amsikking/idv-snouty_light-sheet_microscopy/README.md

# Instant dual-view Snouty (iDV-Snouty) light-sheet microscopy



A scientific publication that describes a new approach to dual-view light-sheet microscopy. This repository 
hosts all the publication materials. Read the publication here:

https://amsikking.github.io/idv-snouty_light-sheet_microscopy

This repository is intended to hold a (mostly) self-contained publication. It contains:

* HTML (`index.html` and `appendix.html`), `javascript` and CSS (`stylesheets`) directories, `images` and `figures` directories and `cad`, `parts` and `zemax` directories.
* A (limited) PDF version of the publication; note that this does not include animated/interactive figures.

This work is licensed under a <a rel="license" href="http://creativecommons.org/licenses/by/4.0/">Creative Commons Attribution 4.0 International License</a>.



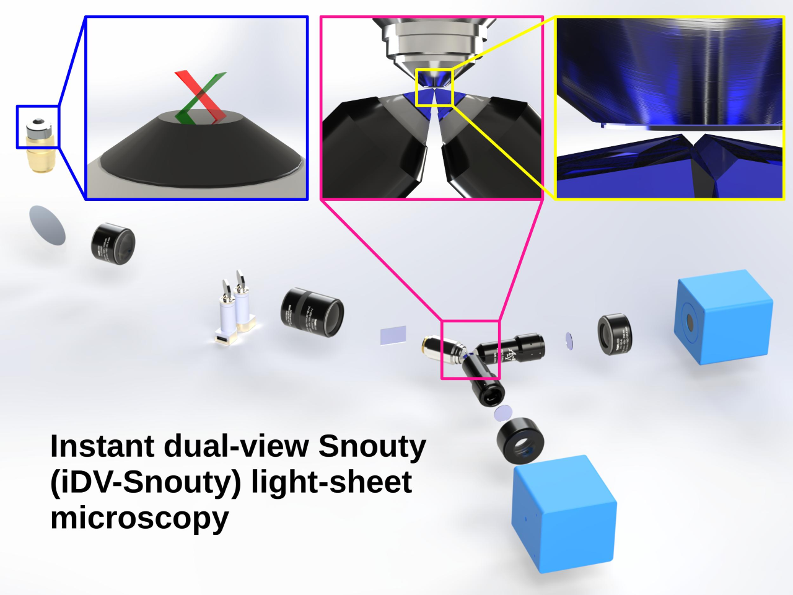
[picture p1: social_preview.png]
social_preivew
