amsikking/idv-snouty_light-sheet_microscopy/cad/improved_design/index.html

# Index of /CAD/improved_design

- 📁 Parent Directory
- 📁 m3_improved_design/
- 📁 rr_dl_volume_improved_design/
- 📄 idv_snouty_improved_design.EASM
- 📄 idv_snouty_improved_design.SLDASM
- 📄 idv_snouty_improved_design.SLDDRW
- 📄 idv_snouty_improved_design.STEP
- 📄 idv_snouty_improved_design.pdf
- 📄 idv_snouty_improved_design_render_overview.png
- 📄 idv_snouty_improved_design_render_rr_zoom1.png
- 📄 idv_snouty_improved_design_render_rr_zoom2.png
- 📄 idv_snouty_improved_design_render_rr_zoom3.png

GitHub Pages Directory Explorer
