amsikking/idv-snouty_light-sheet_microscopy/figures/visual_abstract.odp

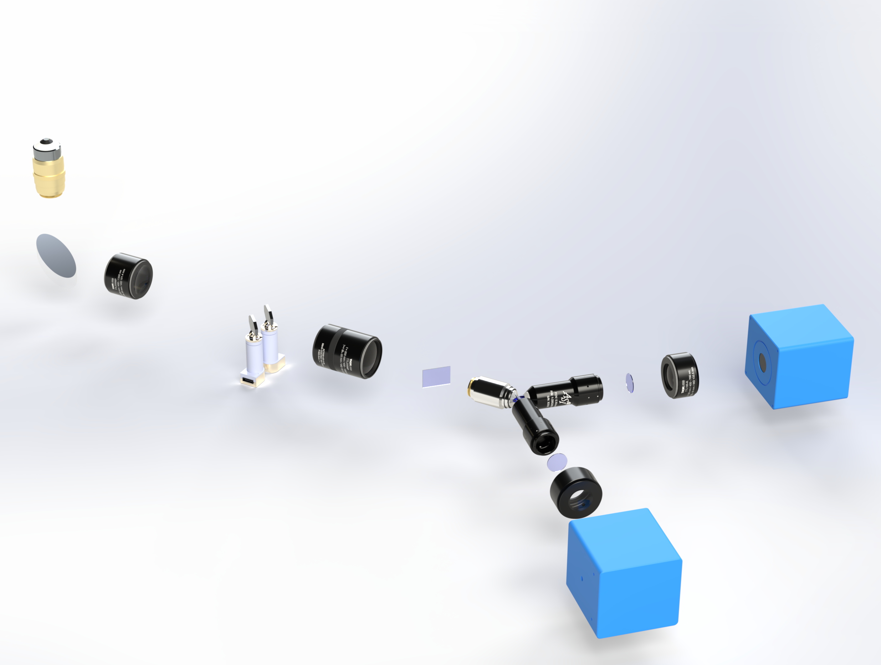
[picture p11: figure]

Instant dual-view Snouty (iDV-Snouty) light-sheet microscopy

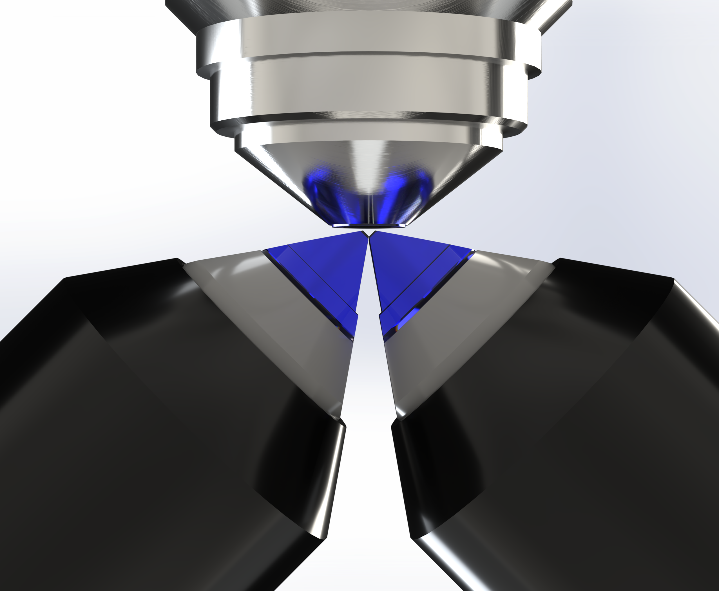
[picture p12: figure]
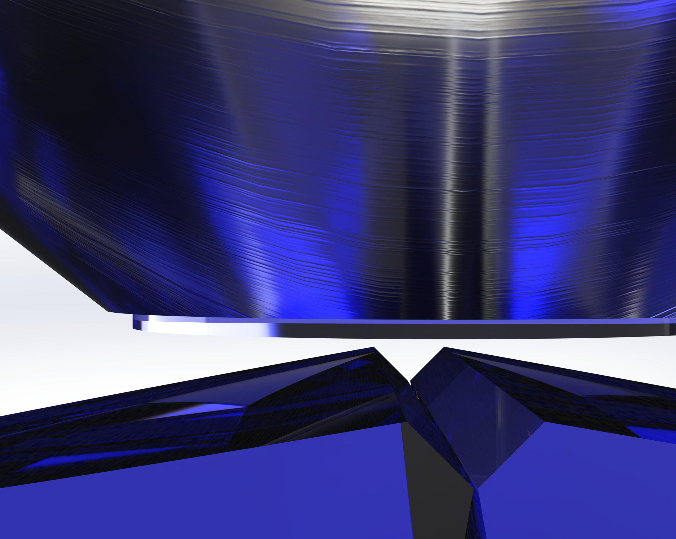
[picture p13: figure]
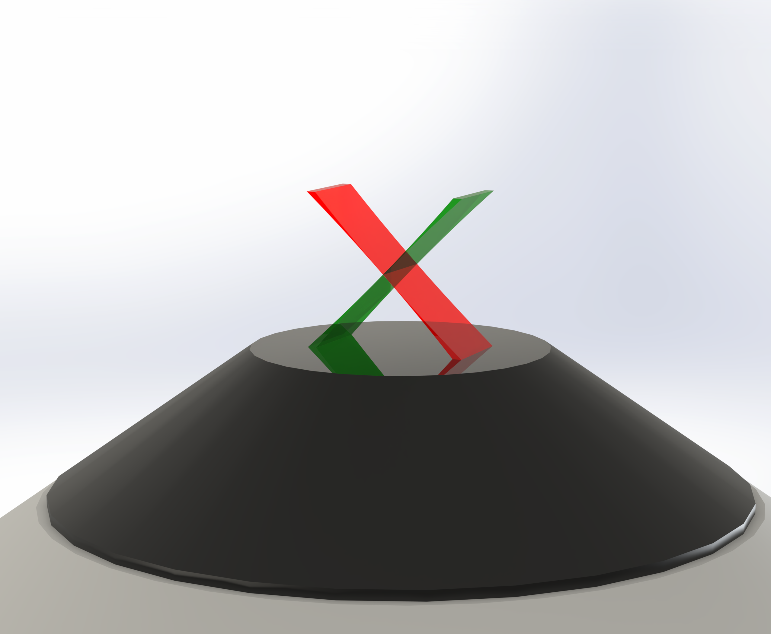
[picture p14: figure]
