amsikking/idv-snouty_light-sheet_microscopy/figures/master.odp

Instant dual-view Snouty: master

FOV1

NA1

NAs

shift

LS1

LS2

tilt

M4

V2

O1

AF*

OS*

DM

O2

FOV2

NA2

CS

Remote

3D image

MRR

shift

FM*

M2

TL2

FOV3

NA3

O3

EM

PG*

tilt

TL1

M1

TL3

C

M3

V1

## Slide 2

Instant dual-view Snouty

LS2

LS1

tilt

M4

V2

Remote

3D image

M2

tilt

M1

M3

V1

## Slide 3

Single-view Snouty: tilt

LS1

tilt

O1

O2

MRR

tilt

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
## Slide 4

FOV1

NA1

Single-view Snouty: NA and FOV

NAs

O1

O2

FOV2

NA2

MRR

M2

TL2

FOV3

NA3

O3

TL1

TL3

M1

M3

V1

## Slide 5

shift

Single-view Snouty: lateral shift

O1

FOV1

OS*

O2

FOV2

MRR

shift

M2

TL2

FOV3

O3

TL1

M1

TL3

M3

V1

## Slide 6

!

Instant dual-view Snouty: axial sample position

deep

regime

LS2

LS1

LS2

LS1

V2

V2

O1

shallow

regime

O1

O2

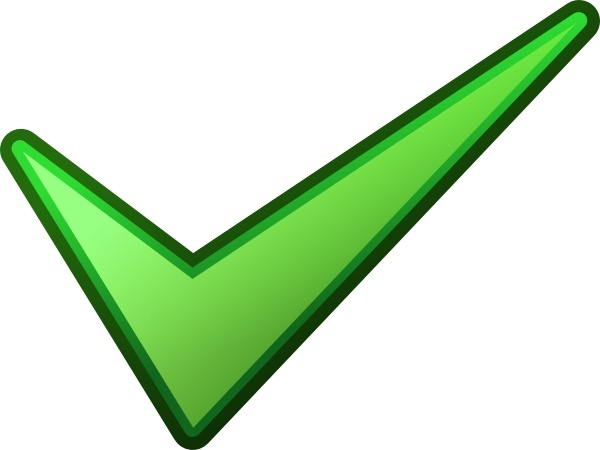
[picture p15: figure]

O2

cross-talk

O3

(V1)

(V2)

O3

(V1)

(V2)

V1

V1

## Slide 7

Instant dual-view Snouty: all labels

FOV1

NA1

NAs

shift

LS1

LS2

tilt

M4

V2

O1

AF*

OS*

DM

O2

FOV2

NA2

CS

MRR

shift

FM*

M2

TL2

FOV3

NA3

O3

EM

PG*

tilt

TL1

M1

TL3

C

M3

V1

## Slide 8

Instant dual-view Snouty: remote space render

current design

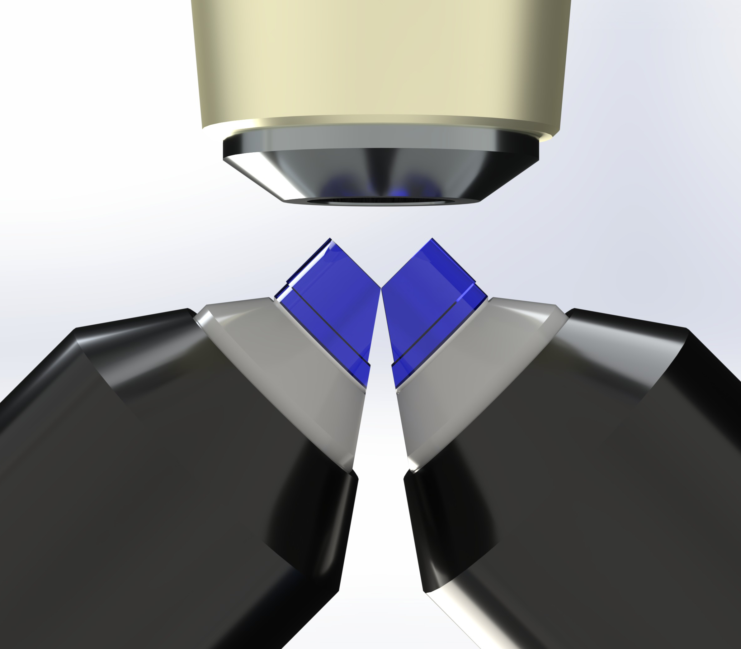
[picture p16: figure]

Nikon 20x0.45 air +

2 × ‘250µm grind’

AMS-AGY v3 objective

improved design

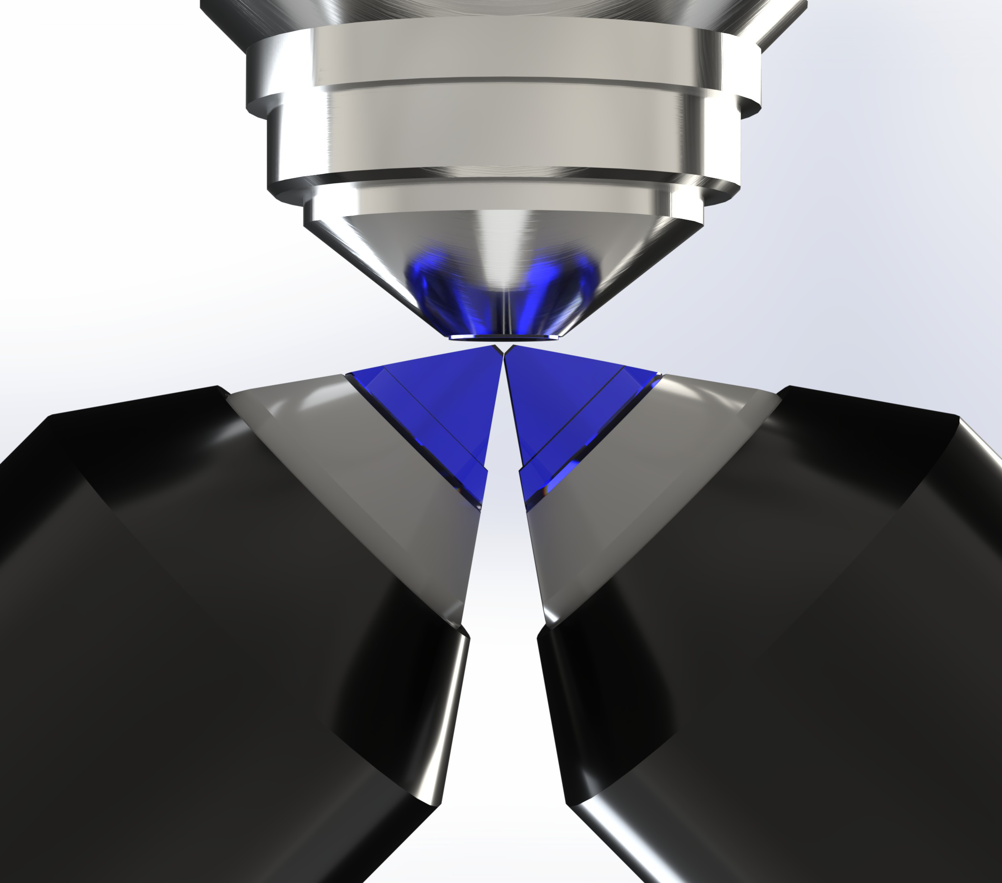
[picture p17: figure]

Nikon 20x0.80 air +

2 × ‘dual-grind’

AMS-AGY v3 objective

O2

O2

O3

O4

O3

O4

## Slide 9

Instant dual-view Snouty: ‘dual-grind’ AMS-AGY v3

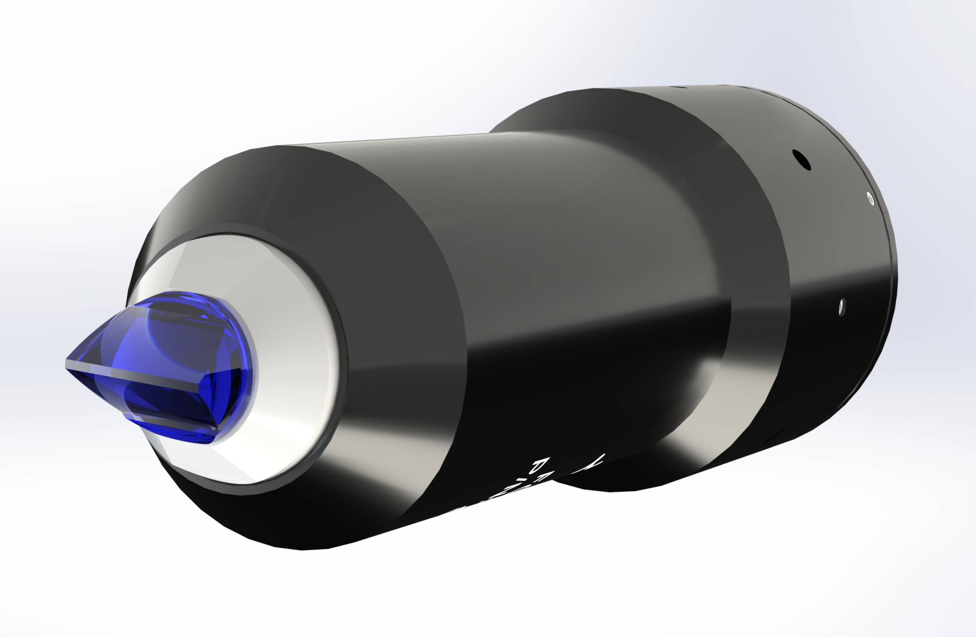
[picture p18: figure]

## Slide 10

FOV3 = 600um

FOV3 = 600um

Snouty light-sheet microscope: 2D field of view (FOV)

FOV2 >= 1100 µm

## Slide 11

Snouty light-sheet microscope: field of view (FOV)

FOV2 = ns FOV1

FOV3 = (NA1 / ns) FOV2

(NA1 / ns = 0.75 here)
