amsikking/idv-snouty_light-sheet_microscopy/cad/current_design/idv_snouty_current_design_render_overview.png

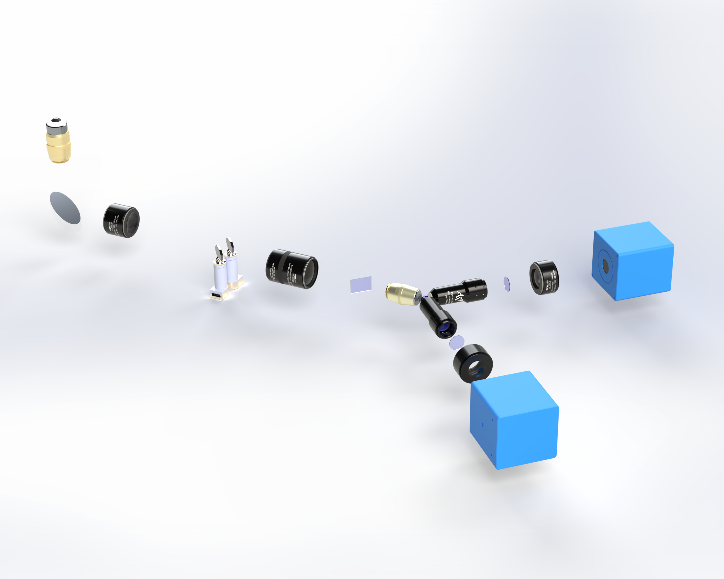
cad/current_design/idv_snouty_current_design_render_overview.png
