amsikking/idv-snouty_light-sheet_microscopy/cad/current_design/idv_snouty_current_design_render_rr_zoom.png

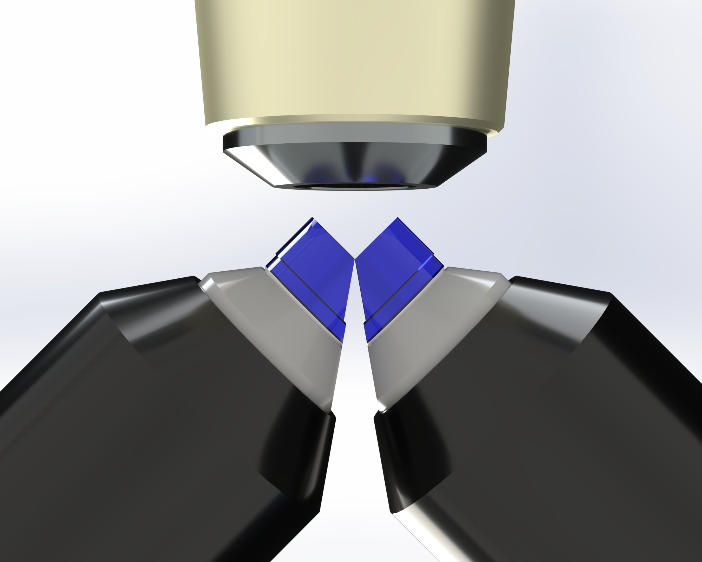
cad/current_design/idv_snouty_current_design_render_rr_zoom.png
