amsikking/idv-snouty_light-sheet_microscopy/cad/improved_design/idv_snouty_improved_design_render_overview.png

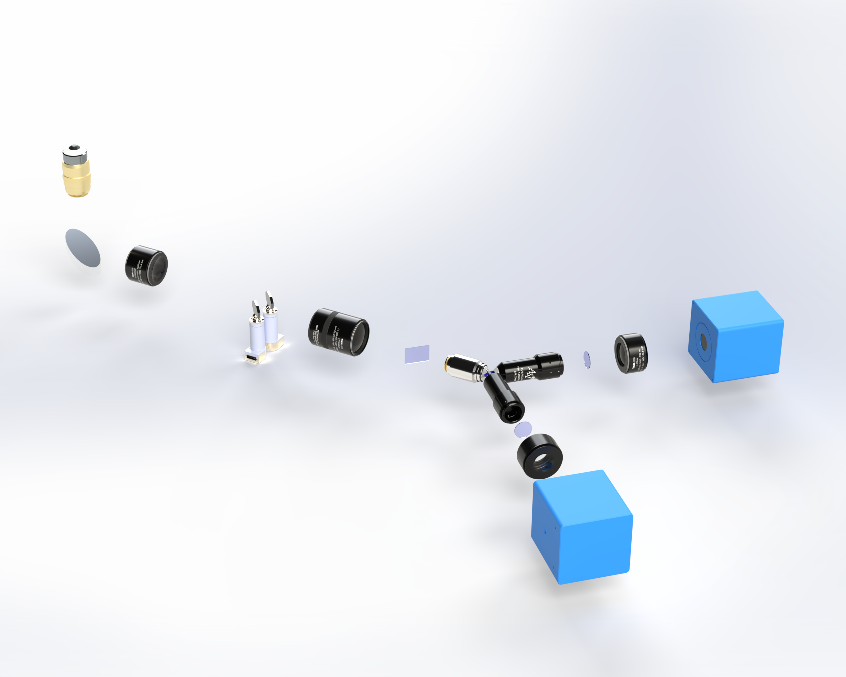
cad/improved_design/idv_snouty_improved_design_render_overview.png
