amsikking/idv-snouty_light-sheet_microscopy/cad/improved_design/idv_snouty_improved_design_render_rr_zoom1.png

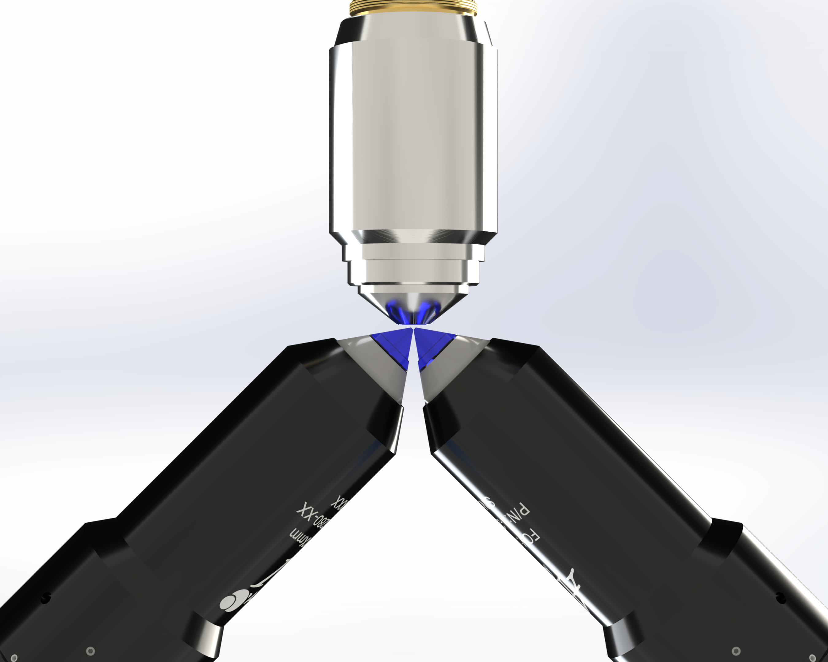
cad/improved_design/idv_snouty_improved_design_render_rr_zoom1.png
