amsikking/idv-snouty_light-sheet_microscopy/cad/o1/o1_lightsheets_render_zoom1.png

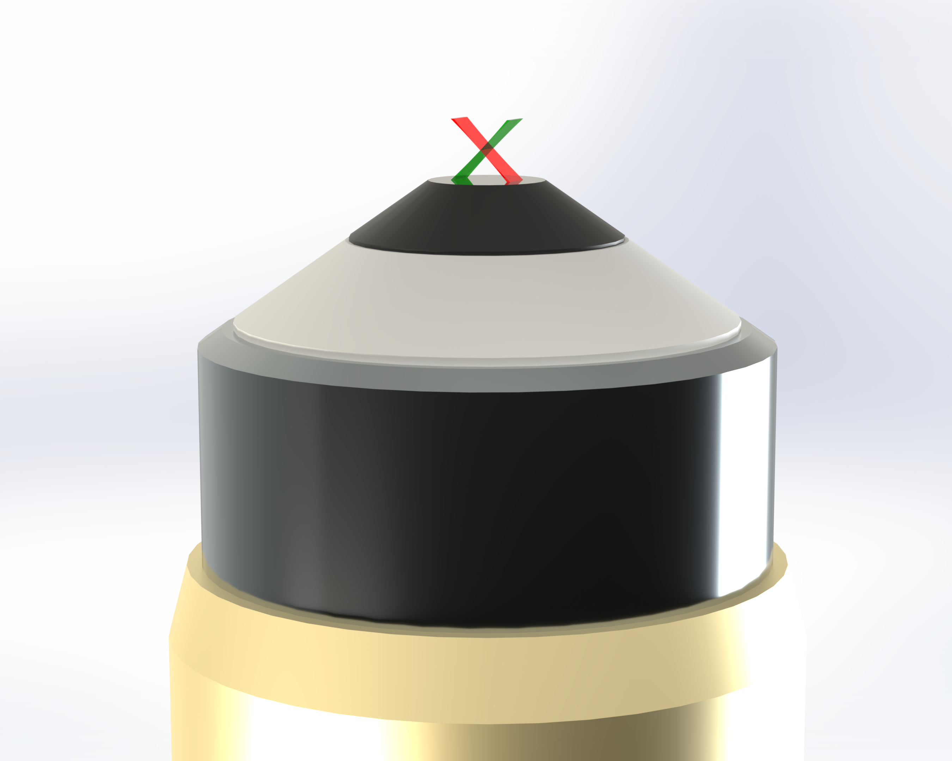
cad/o1/o1_lightsheets_render_zoom1.png
