amsikking/idv-snouty_light-sheet_microscopy/cad/o3/ams-agy_v3_57-14-7_revb_dual_grind_render.png

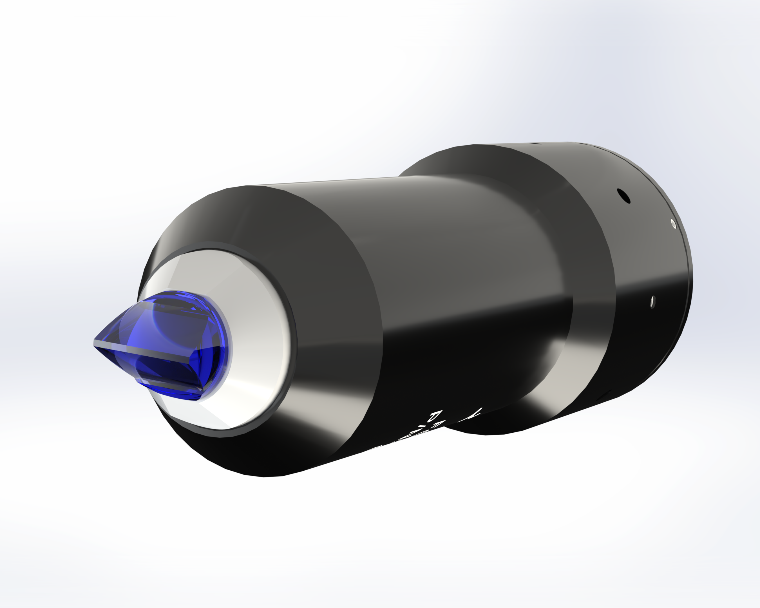
cad/o3/ams-agy_v3_57-14-7_revb_dual_grind_render.png
