amsikking/idv-snouty_light-sheet_microscopy/figures/ams-agy_v3_dual_grind_render.png

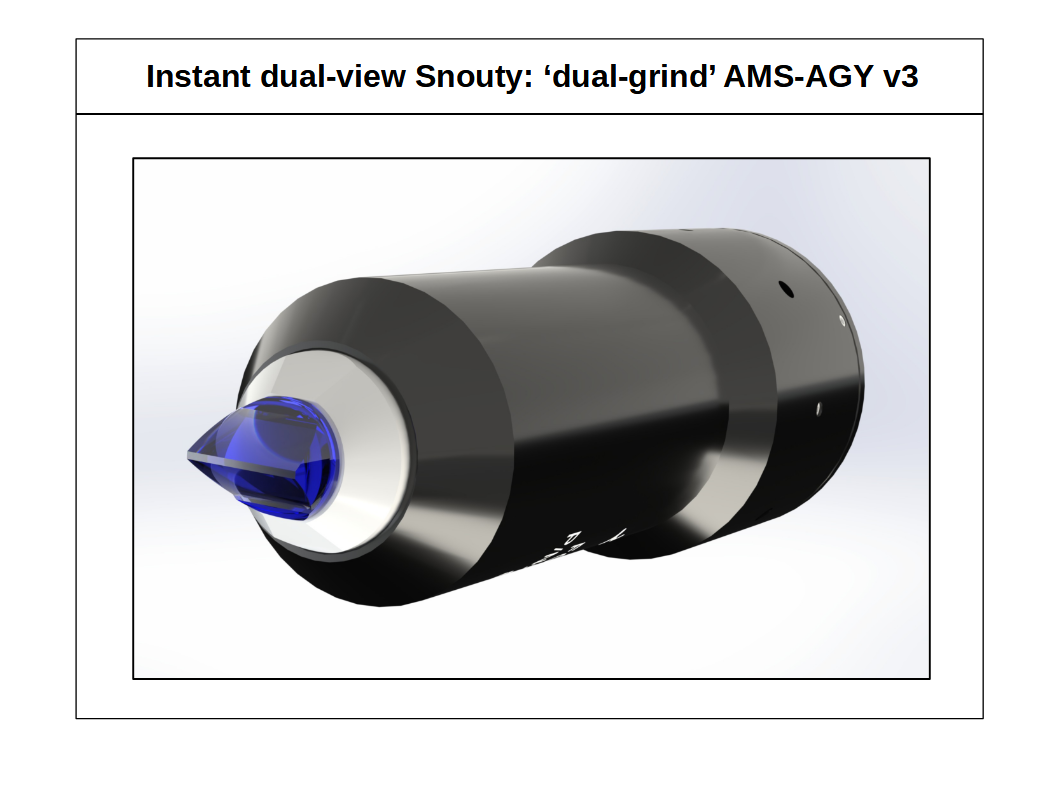
figures/ams-agy_v3_dual_grind_render.png
