amsikking/idv-snouty_light-sheet_microscopy/figures/idv_snouty.png

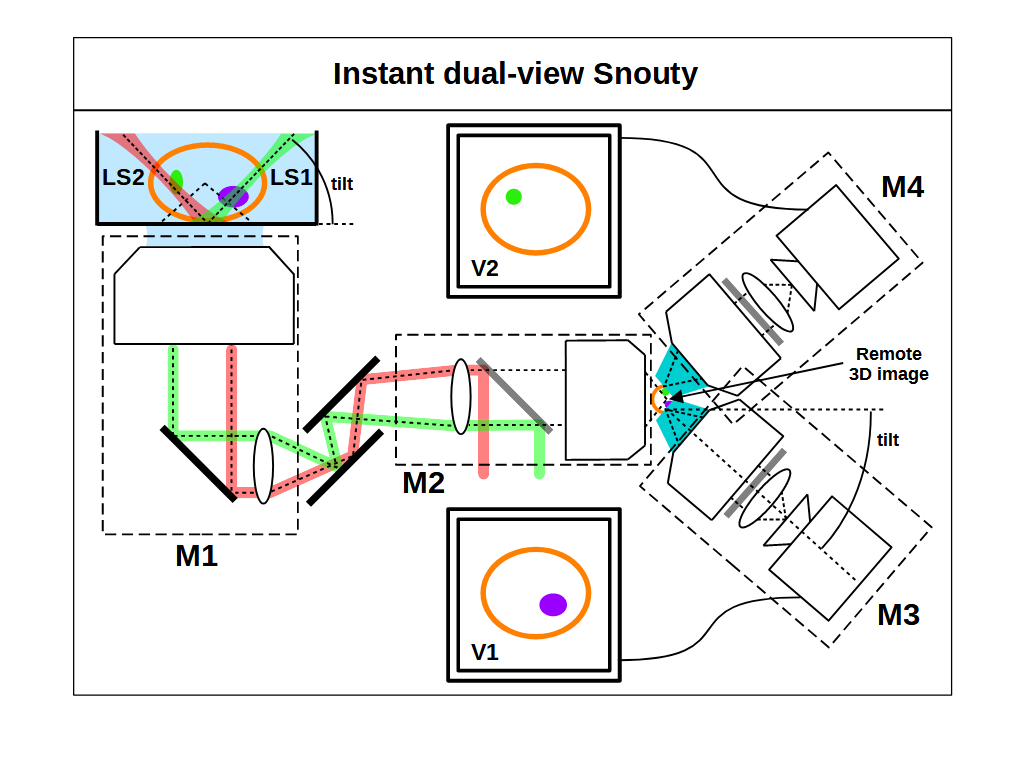
figures/idv_snouty.png
