amsikking/idv-snouty_light-sheet_microscopy/figures/idv_snouty_axial_sample_position.png

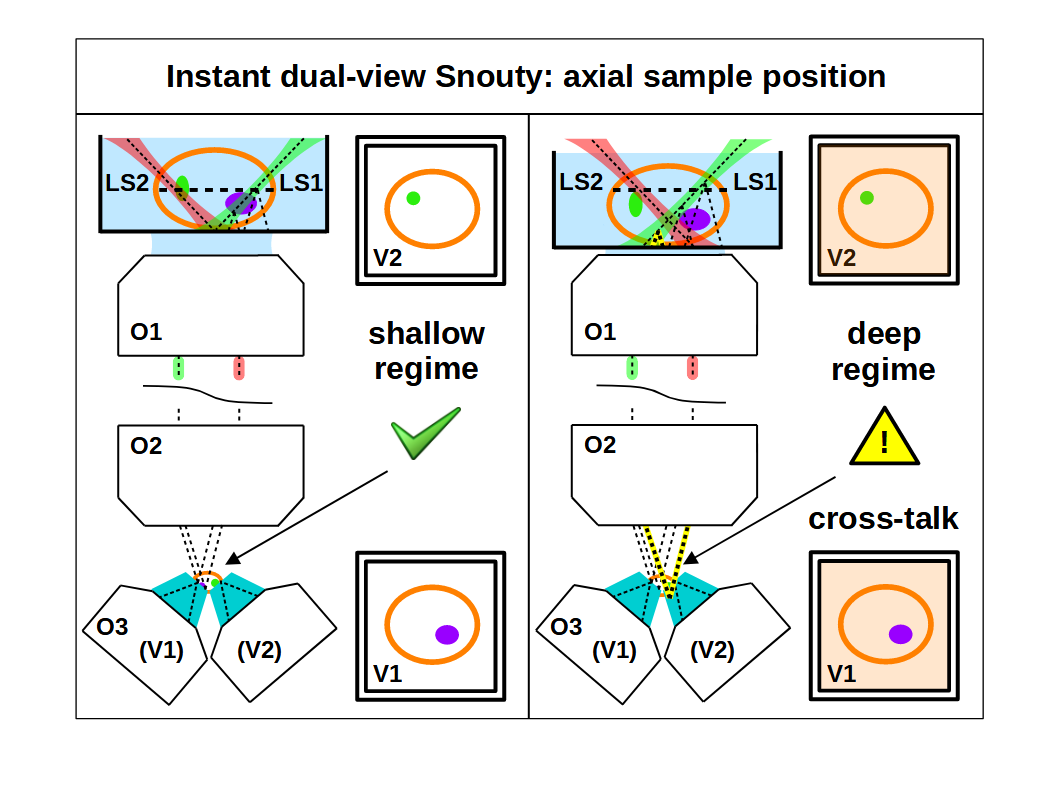
figures/idv_snouty_axial_sample_position.png
