amsikking/idv-snouty_light-sheet_microscopy/figures/idv_snouty_improved_design_3d_fov_detail.png

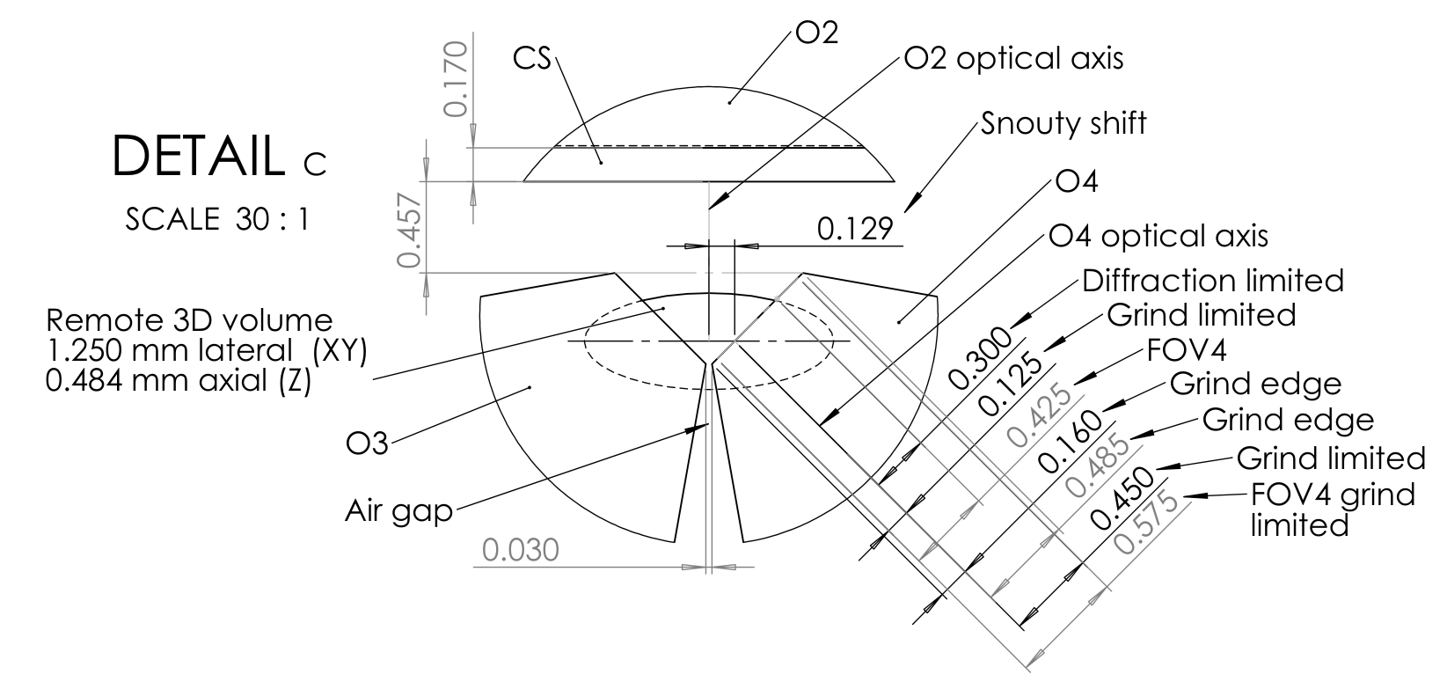
figures/idv_snouty_improved_design_3d_fov_detail.png
