amsikking/idv-snouty_light-sheet_microscopy/figures/idv_snouty_remote_space_render.png

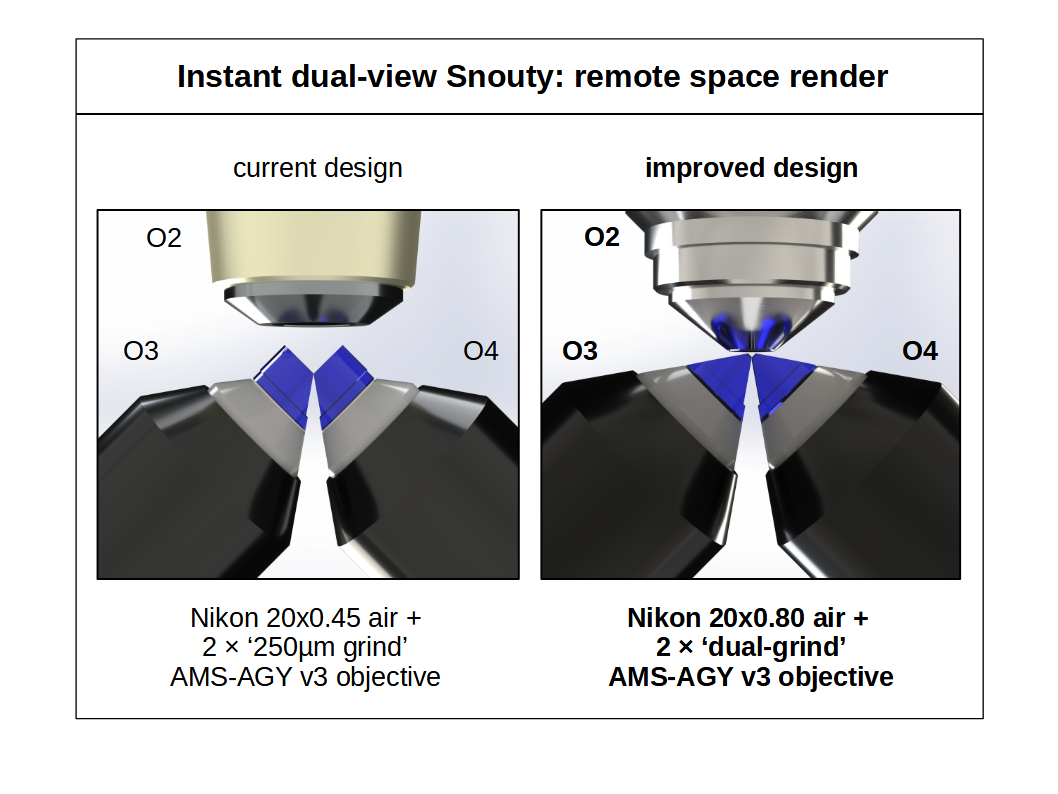
figures/idv_snouty_remote_space_render.png
