amsikking/idv-snouty_light-sheet_microscopy/figures/single_view_snouty_lateral_shift.png

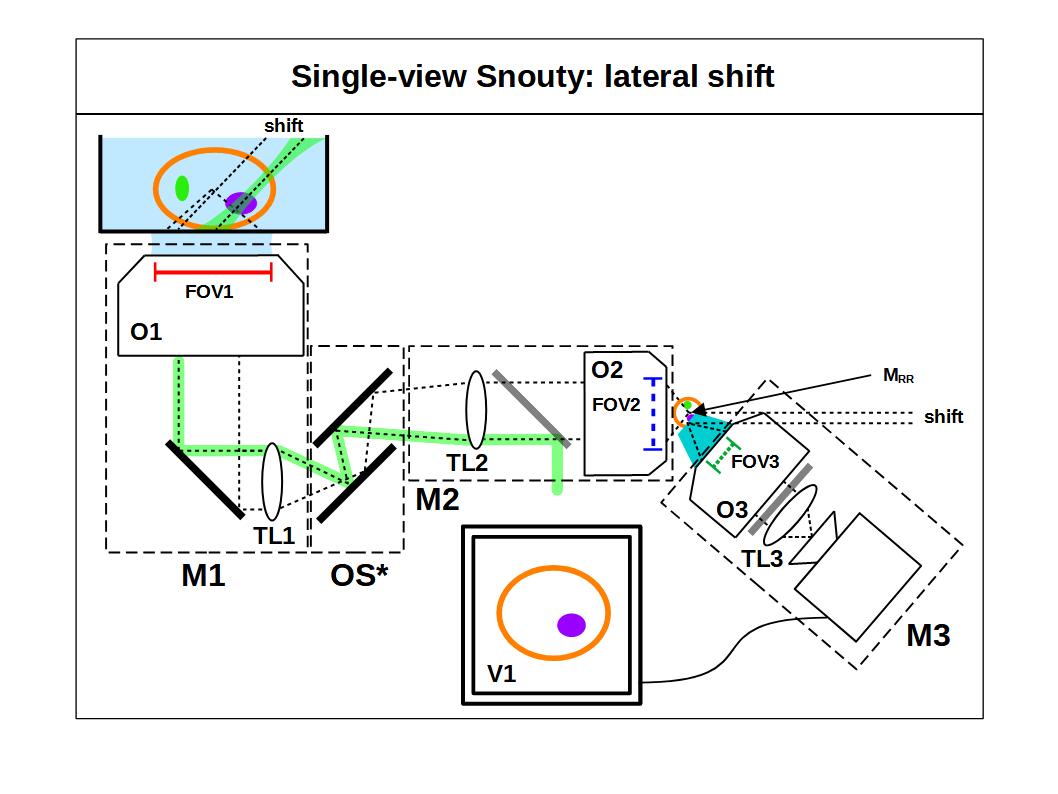
figures/single_view_snouty_lateral_shift.png
