amsikking/idv-snouty_light-sheet_microscopy/figures/single_view_snouty_na_and_fov.png

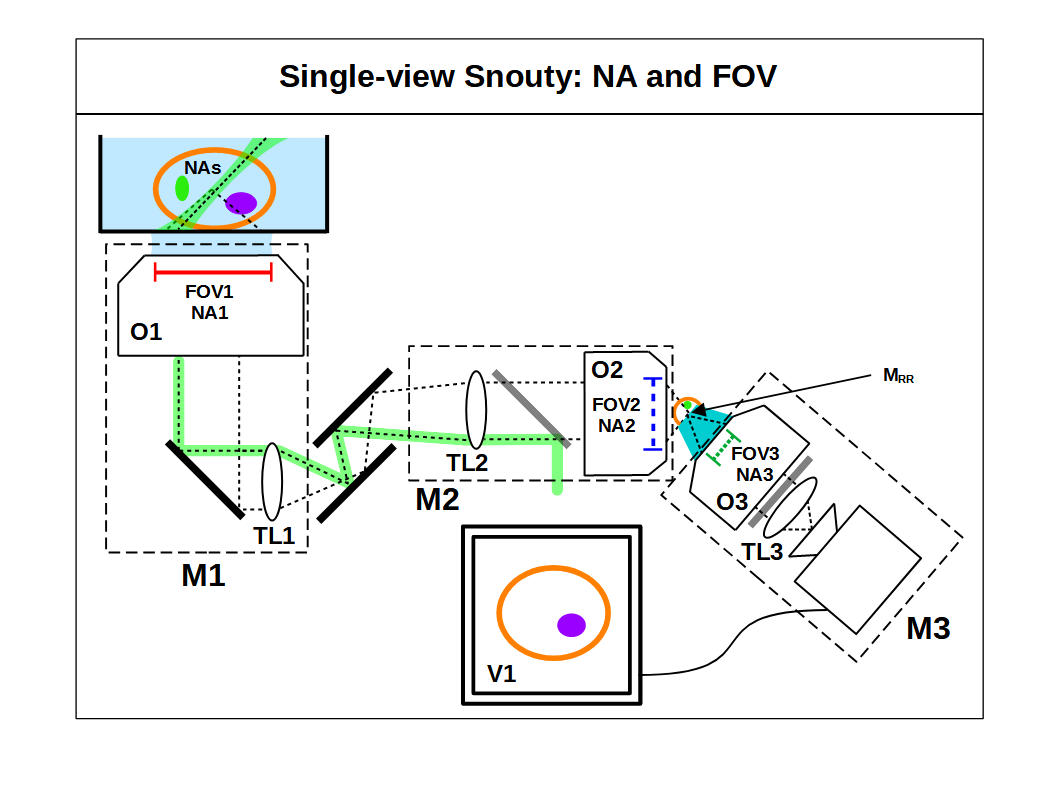
figures/single_view_snouty_na_and_fov.png
