amsikking/idv-snouty_light-sheet_microscopy/zemax/idv_snouty_layout.png

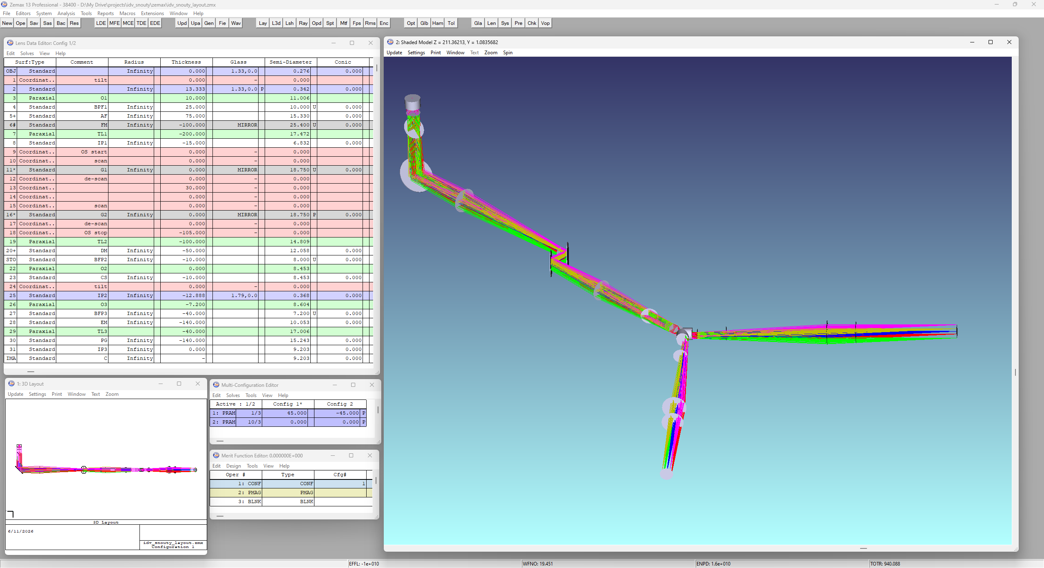
zemax/idv_snouty_layout.png
