amsikking/idv-snouty_light-sheet_microscopy/zemax/m3/ams-agy_v3_57-14-7_revb_reverse_ttl180-a_na0.97.png

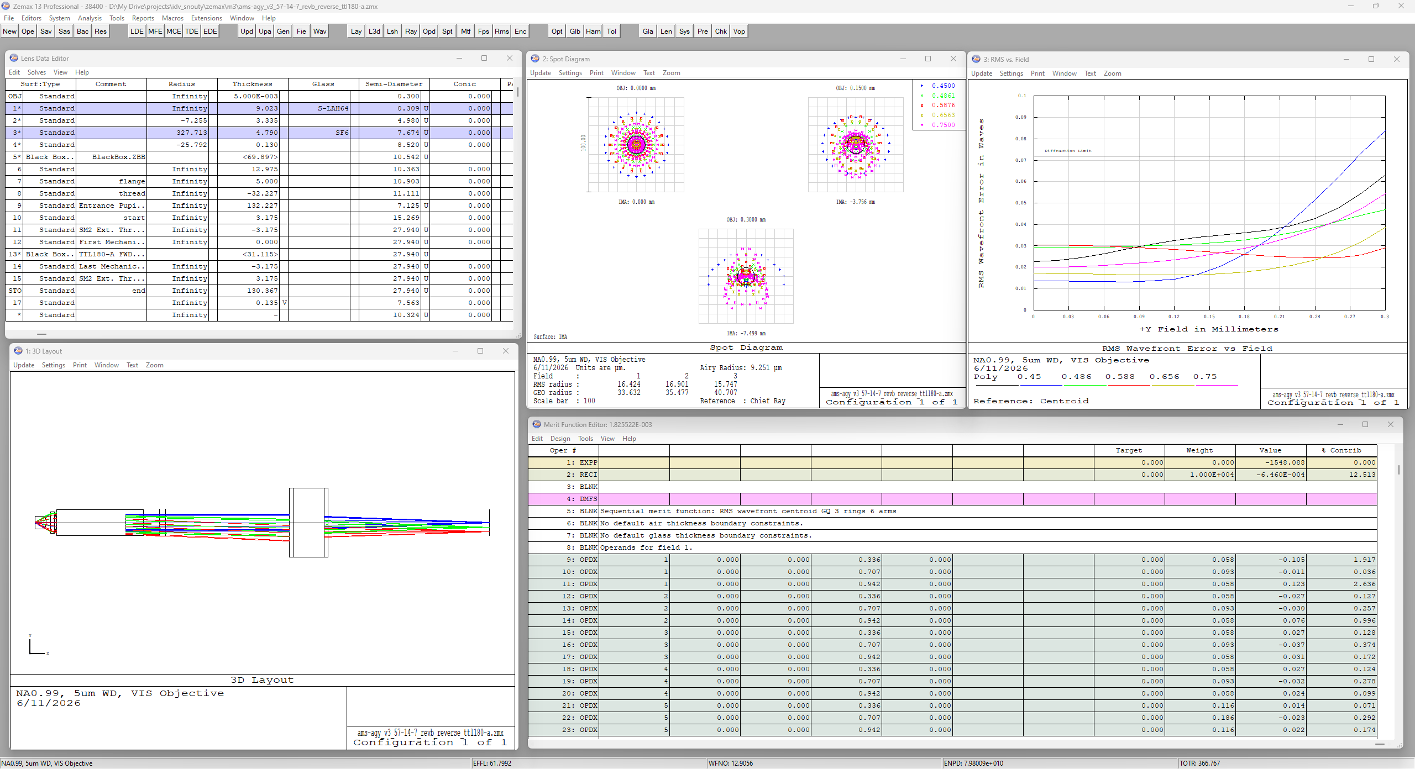
zemax/m3/ams-agy_v3_57-14-7_revb_reverse_ttl180-a_na0.97.png
