amsikking/idv-snouty_light-sheet_microscopy/zemax/tl1/thorlabs_ttl200mp_200mm_tube_lens.png

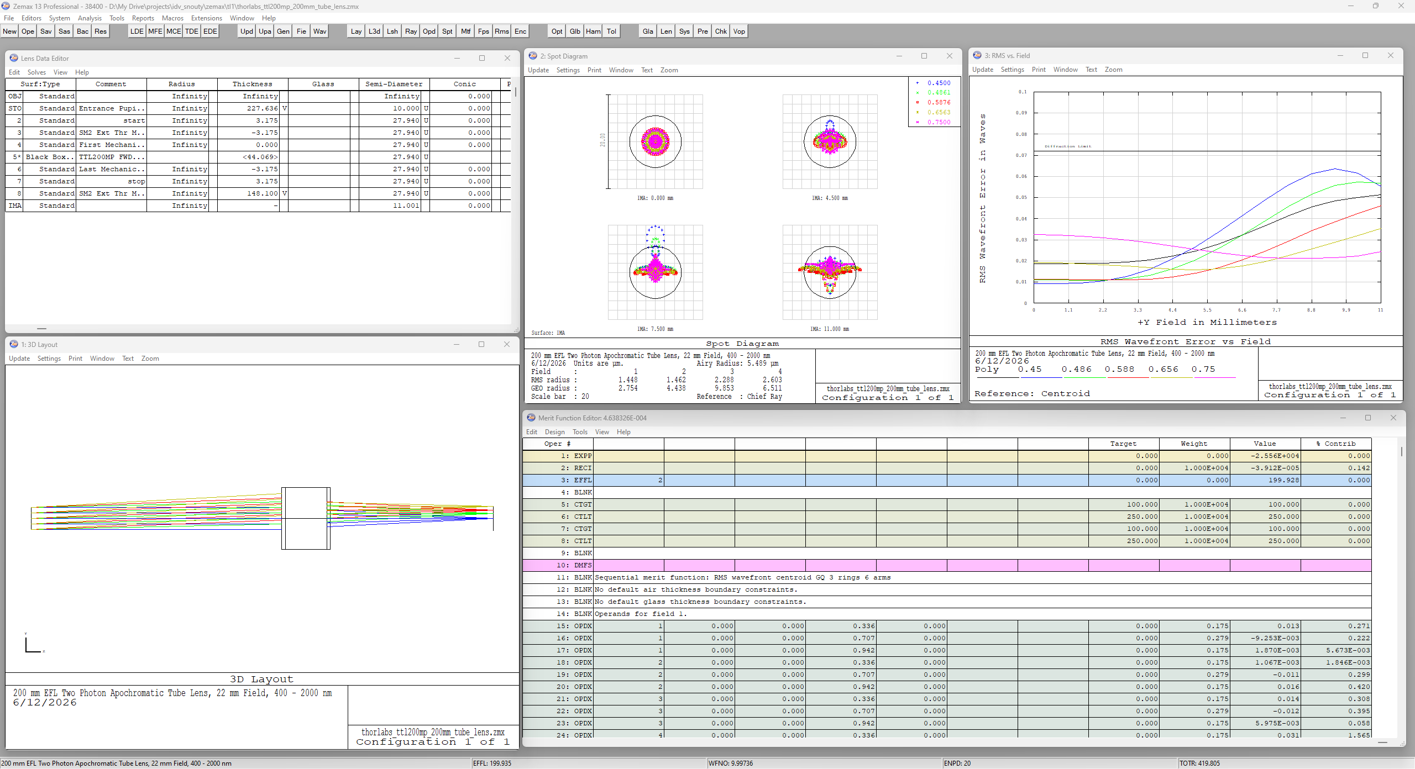
zemax/tl1/thorlabs_ttl200mp_200mm_tube_lens.png
