amsikking/idv-snouty_light-sheet_microscopy/parts/mrd70270.png

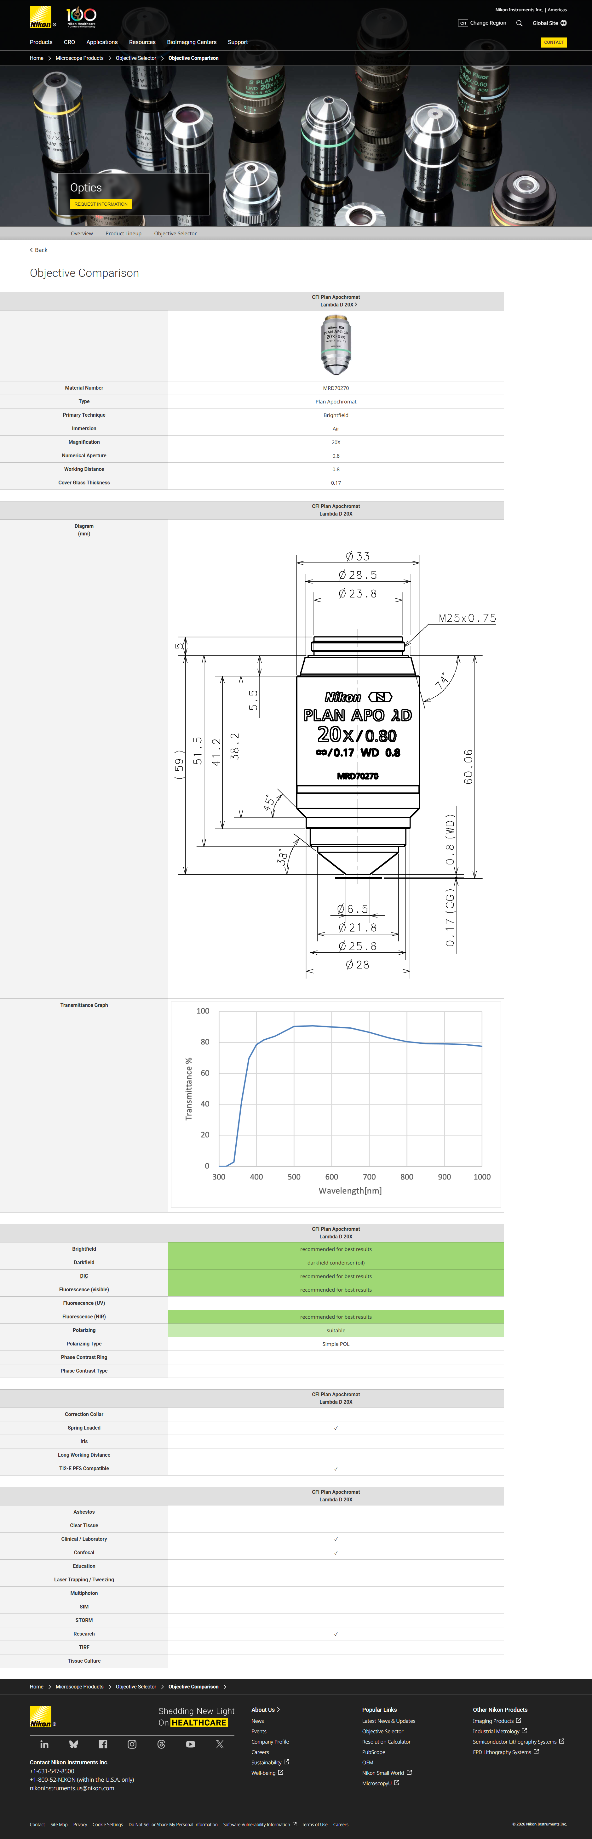
parts/mrd70270.png
