amsikking/idv-snouty_light-sheet_microscopy/parts/mrd70270_ofn25.png

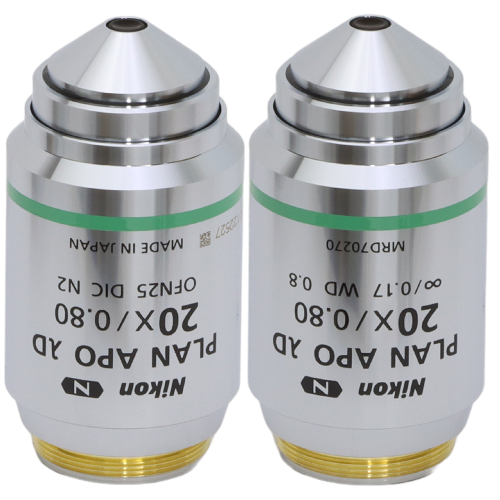
parts/mrd70270_ofn25.png
