amsikking/idv-snouty_light-sheet_microscopy/parts/mrd77205.png

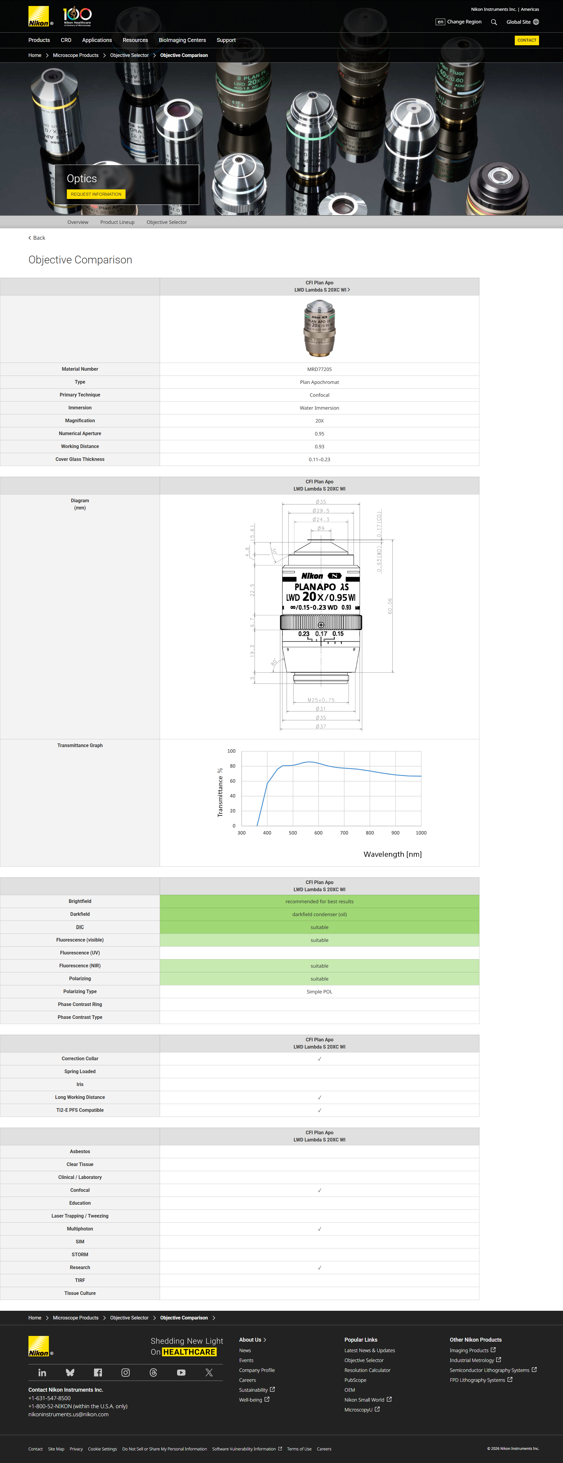
parts/mrd77205.png
