amsikking/idv-snouty_light-sheet_microscopy/parts/mrd77205_ofn25.png

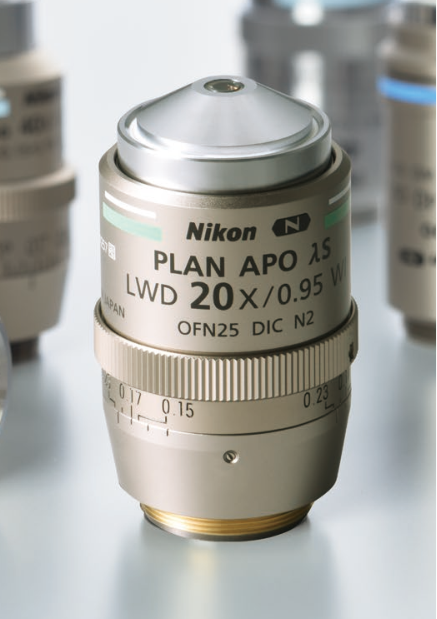
parts/mrd77205_ofn25.png
