amsikking/idv-snouty_light-sheet_microscopy/parts/mrd77226.png

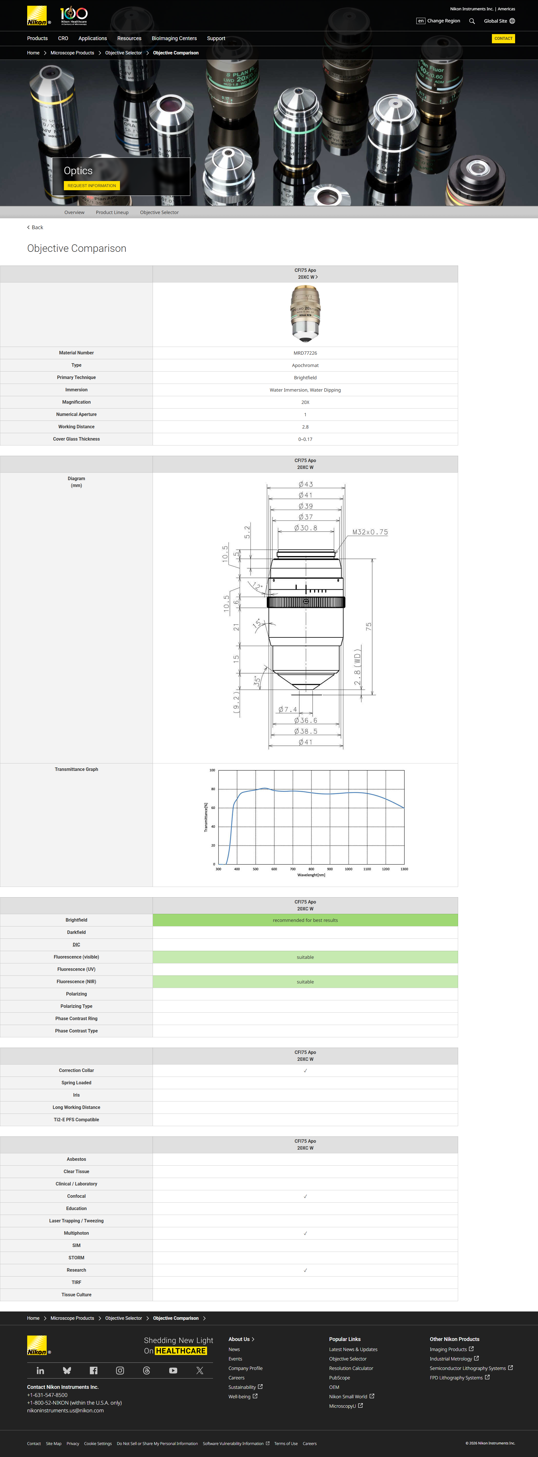
parts/mrd77226.png
