amsikking/idv-snouty_light-sheet_microscopy/parts/mrh08230_ofn22.png

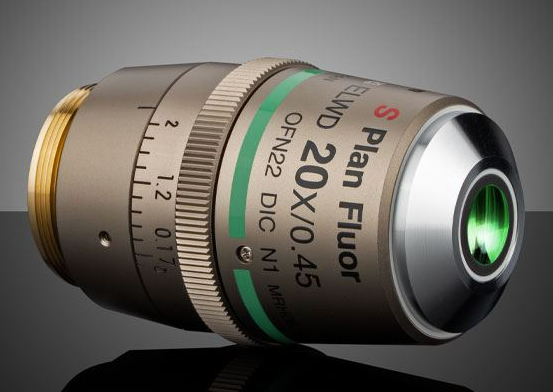
parts/mrh08230_ofn22.png
