amsikking/idv-snouty_light-sheet_microscopy/parts/zet405488561640mv2.png

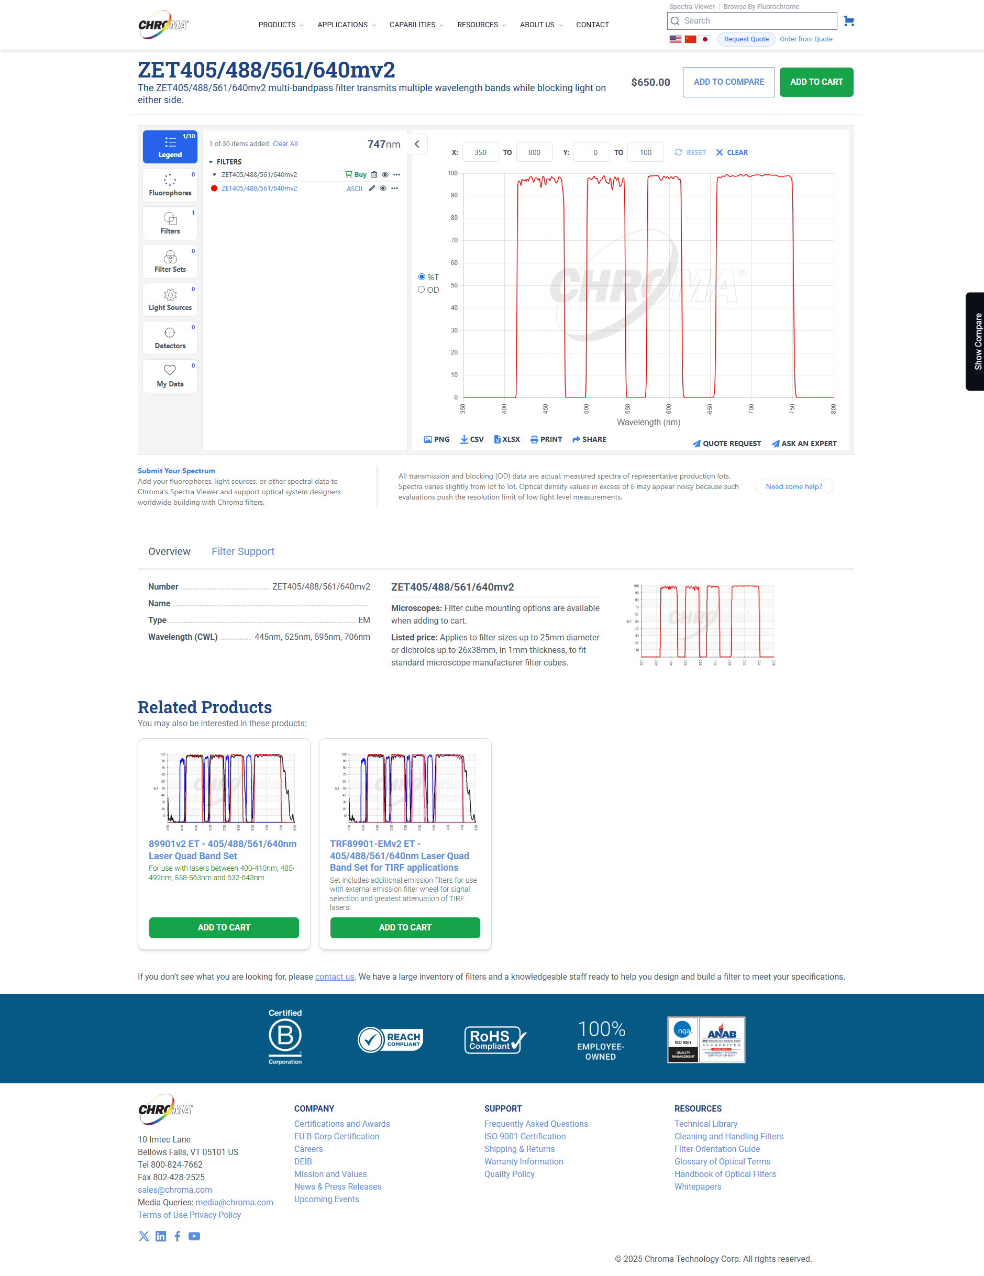
parts/zet405488561640mv2.png
