amsikking/idv-snouty_light-sheet_microscopy/parts/zt405488561640rpcv2.png

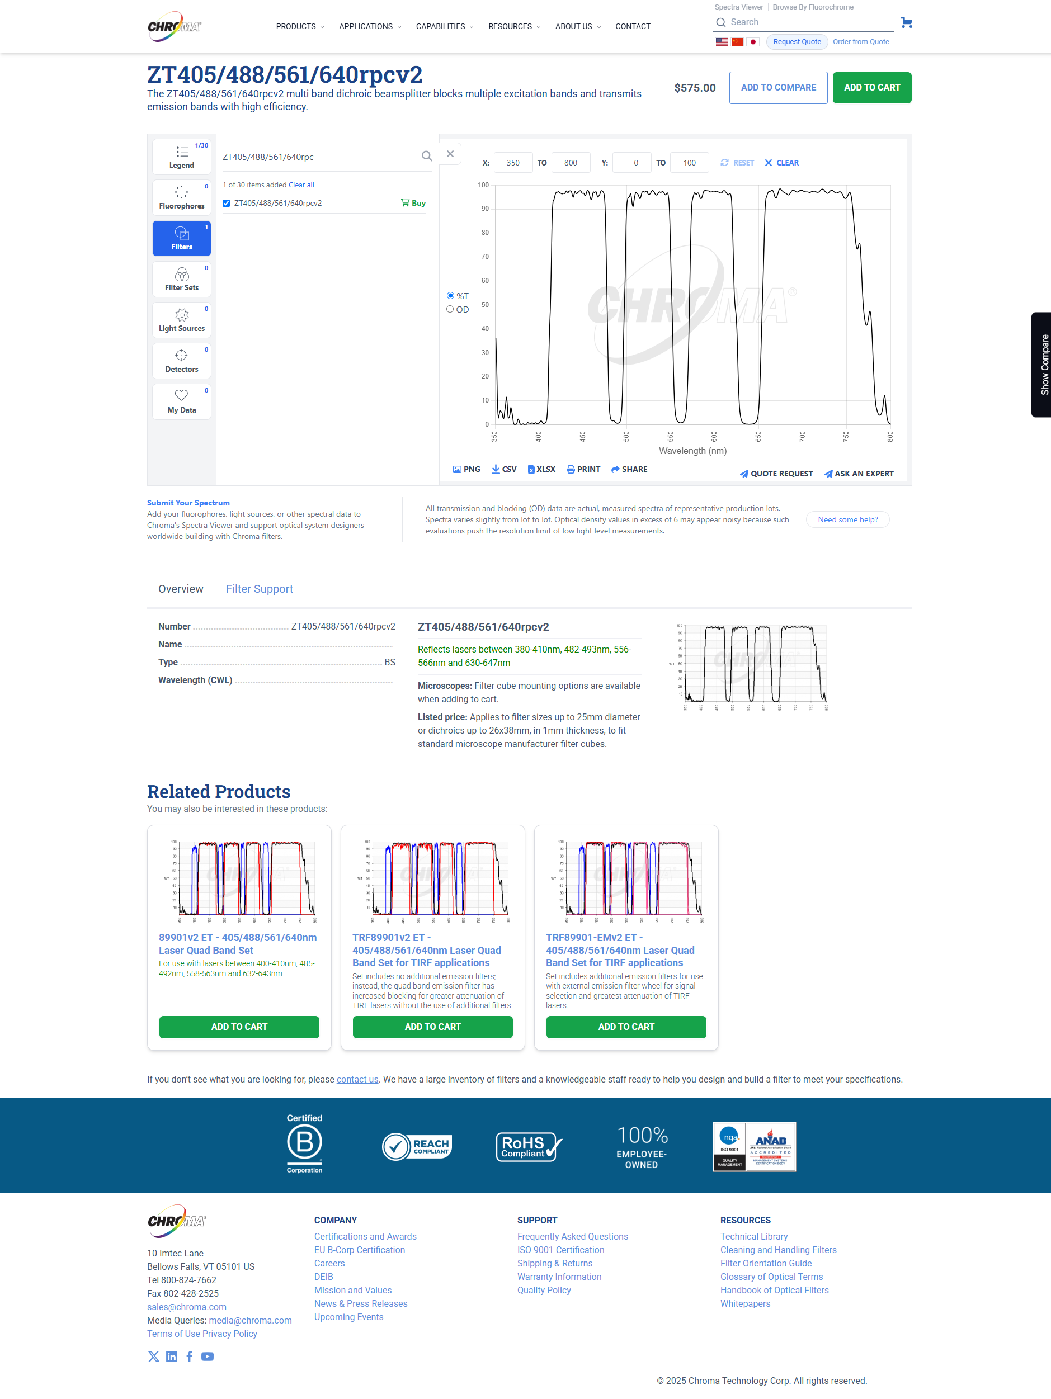
parts/zt405488561640rpcv2.png
