amsikking/idv-snouty_light-sheet_microscopy/cad/2d_fov/2d_fov.SLDASM

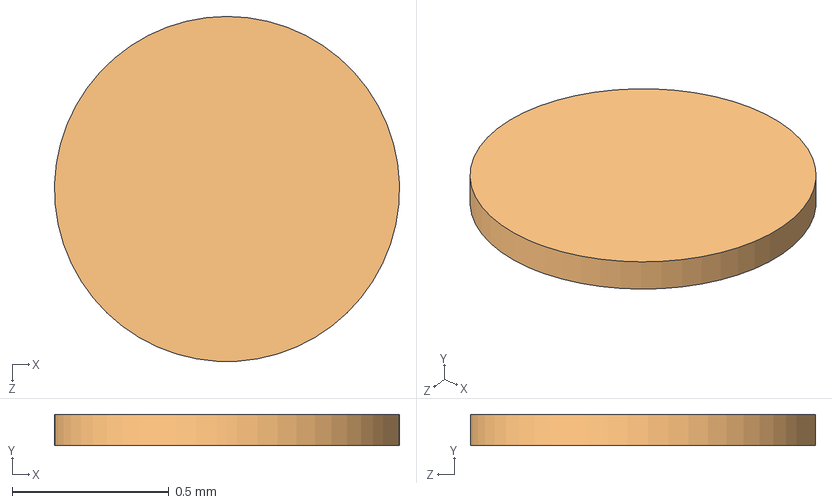
[picture p45: CAD file, 2026-07-15]
cad/2d_fov/2d_fov.SLDASM
1.10 x 0.1 x 1.10 mm
2d_fov_o2
2d_fov_ams-agy_v3 x 2
