amsikking/idv-snouty_light-sheet_microscopy/cad/2d_fov/2d_fov_ams-agy_v3.SLDPRT

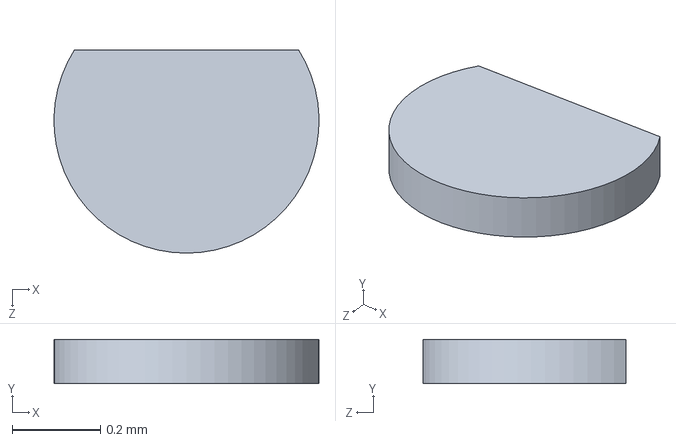
[picture p46: CAD file, 2026-07-15]
cad/2d_fov/2d_fov_ams-agy_v3.SLDPRT
0.6 x 0.1 x 0.46 mm
