amsikking/idv-snouty_light-sheet_microscopy/cad/c/pco_edge10_bi_clhs.STEP

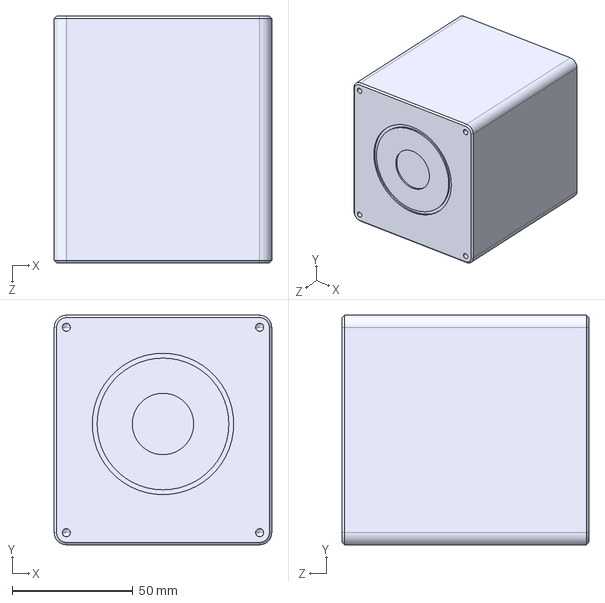
[picture p47: CAD file, 2026-07-15]
cad/c/pco_edge10_bi_clhs.STEP
90.0 x 95.0 x 102.2 mm
