amsikking/idv-snouty_light-sheet_microscopy/cad/cs/coverslip_0.17mm_thick.STEP

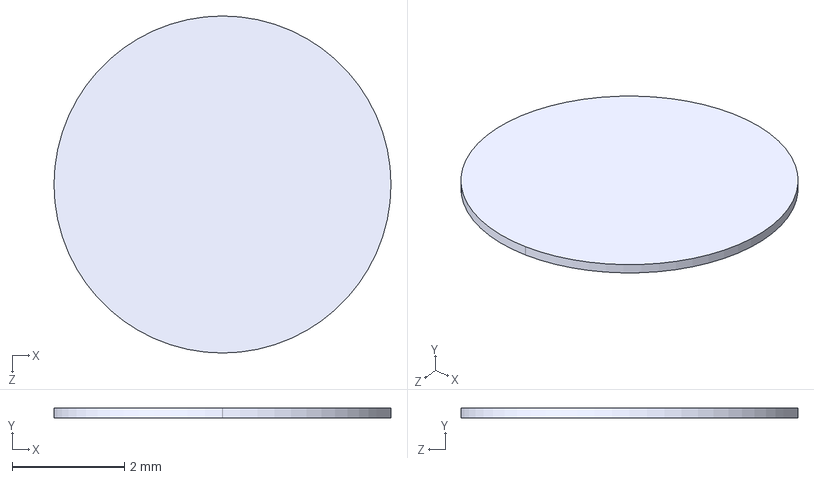
[picture p48: CAD file, 2026-07-15]
cad/cs/coverslip_0.17mm_thick.STEP
6.00 x 0.17 x 6.00 mm
