amsikking/idv-snouty_light-sheet_microscopy/cad/current_design/idv_snouty_current_design.STEP

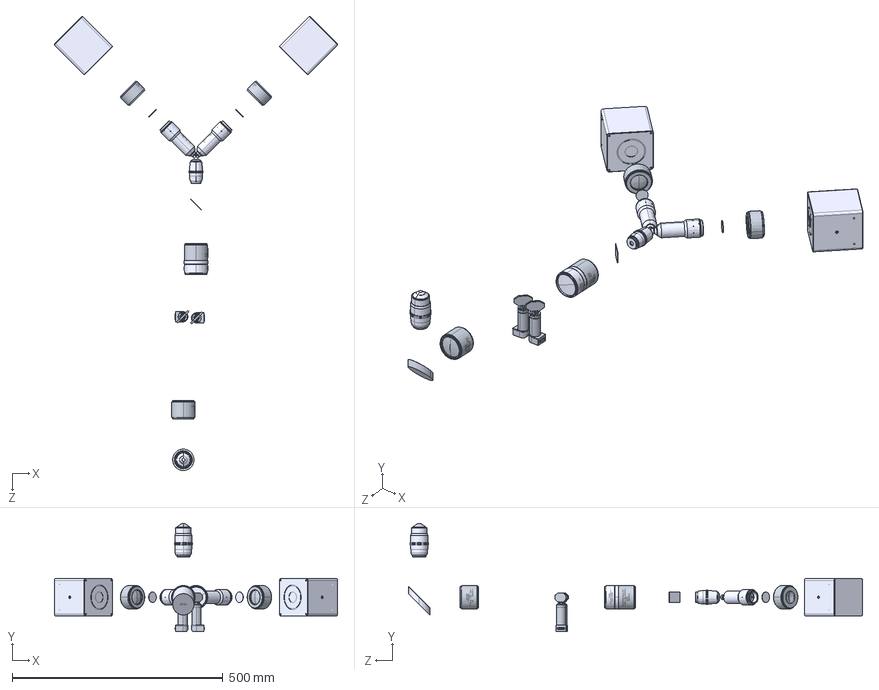
[picture p49: CAD file, 2026-07-15]
cad/current_design/idv_snouty_current_design.STEP
672.2 x 256.4 x 1076.5 mm
nikon_mrd77226_20x1.0_water_objective
thorlabs_bbe2-e02_2in_elliptical_mirror
thorlabs_ttl200mp_200mm_tube_lens x 2
thorlabs_qs20x-ag_20mm_galvo x 2
thorlabs_act508-400-a-ml_400mm_achromat
thorlabs_sm2l03_0.3in_lens_tube
chroma_zt405488561640rpcv2_rectangular_dichroic_1mm_thick
nikon_mrh08230_20x0.45_air_objective
ams-agy_v3_57-14-7_revb_0.25mm_grind x 2
chroma_zet405488561640mv2_emission_filter_1mm_thick x 2
thorlabs_ttl180-a_180mm_tube_lens x 2
pco_edge10_bi_clhs x 2
rr_dl_volume_current_design
