amsikking/idv-snouty_light-sheet_microscopy/cad/current_design/m3_current_design/m3_current_design.STEP

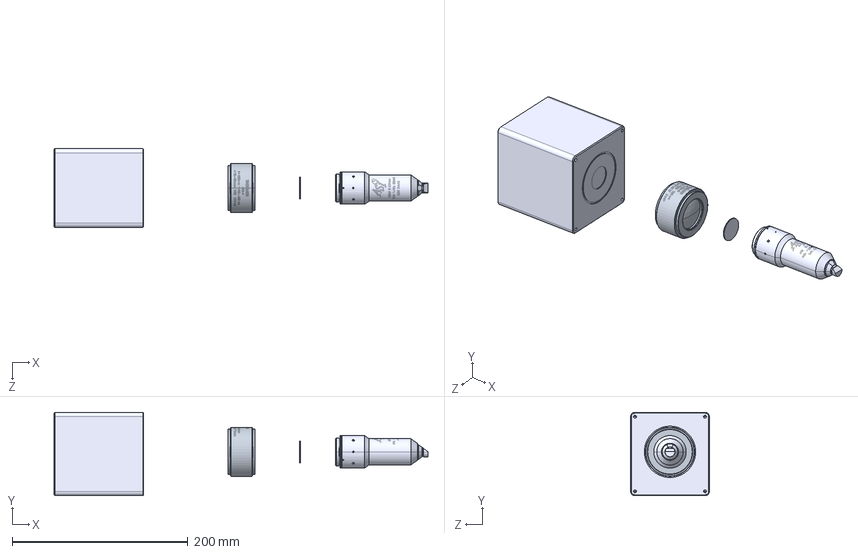
[picture p50: CAD file, 2026-07-15]
cad/current_design/m3_current_design/m3_current_design.STEP
426.1 x 95.0 x 90.0 mm
ams-agy_v3_57-14-7_revb_0.25mm_grind
chroma_zet405488561640mv2_emission_filter_1mm_thick
thorlabs_ttl180-a_180mm_tube_lens
pco_edge10_bi_clhs
