amsikking/idv-snouty_light-sheet_microscopy/cad/current_design/rr_dl_volume_current_design/rr_dl_volume_current_design.STEP

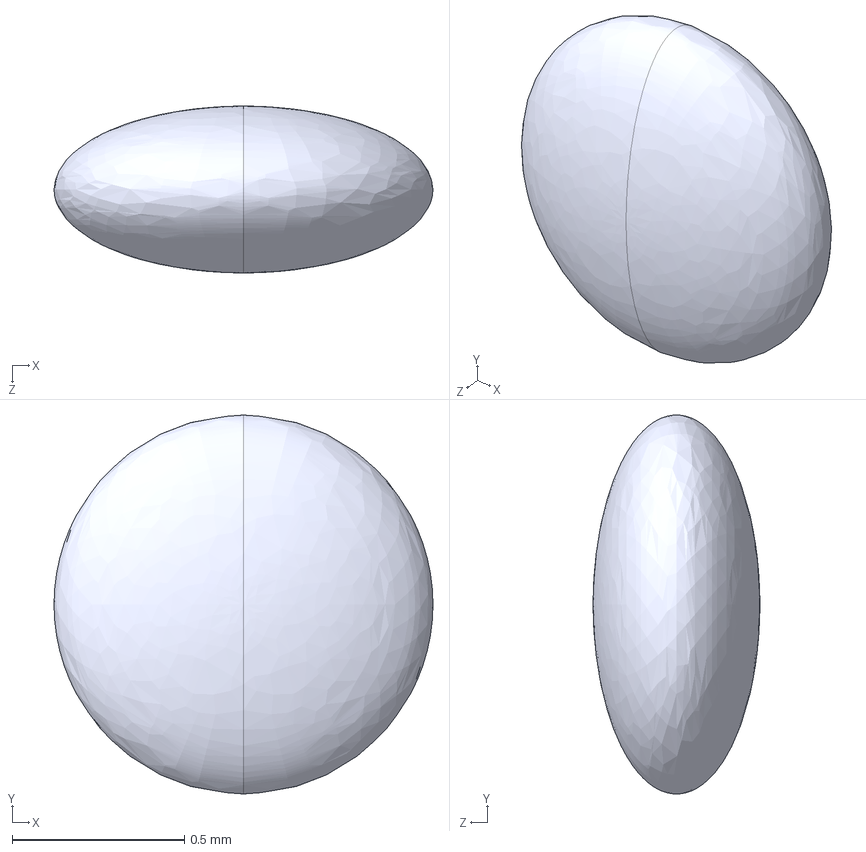
[picture p51: CAD file, 2026-07-15]
cad/current_design/rr_dl_volume_current_design/rr_dl_volume_current_design.STEP
1.10 x 1.10 x 0.484 mm
