amsikking/idv-snouty_light-sheet_microscopy/cad/dm/chroma_zt405488561640rpcv2_rectangular_dichroic_1mm_thick.STEP

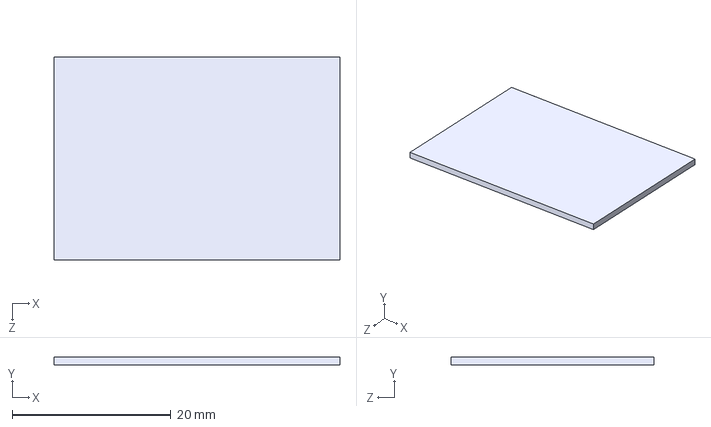
[picture p52: CAD file, 2026-07-15]
cad/dm/chroma_zt405488561640rpcv2_rectangular_dichroic_1mm_thick.STEP
36.0 x 1.00 x 25.5 mm
