amsikking/idv-snouty_light-sheet_microscopy/cad/em/chroma_zet405488561640mv2_emission_filter_1mm_thick.STEP

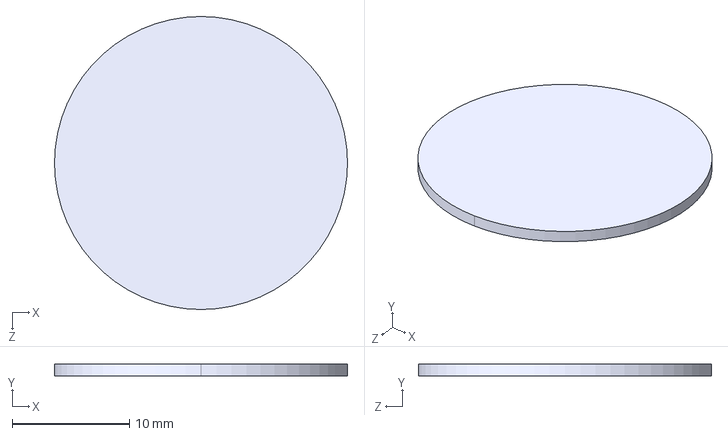
[picture p53: CAD file, 2026-07-15]
cad/em/chroma_zet405488561640mv2_emission_filter_1mm_thick.STEP
25.0 x 1.00 x 25.0 mm
