amsikking/idv-snouty_light-sheet_microscopy/cad/improved_design/m3_improved_design/m3_improved_design.STEP

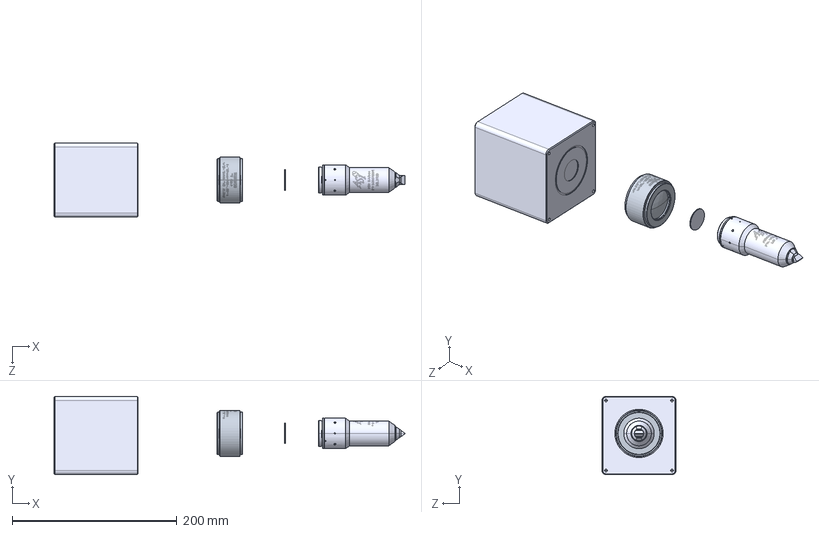
[picture p54: CAD file, 2026-07-15]
cad/improved_design/m3_improved_design/m3_improved_design.STEP
426.1 x 95.0 x 90.0 mm
ams-agy_v3_57-14-7_revb_dual_grind
chroma_zet405488561640mv2_emission_filter_1mm_thick
thorlabs_ttl180-a_180mm_tube_lens
pco_edge10_bi_clhs
