amsikking/idv-snouty_light-sheet_microscopy/cad/improved_design/rr_dl_volume_improved_design/rr_dl_volume_improved_design.STEP

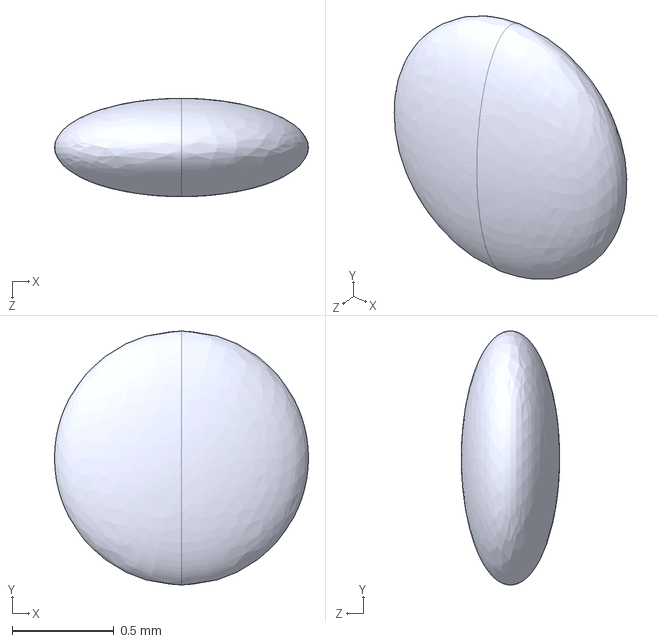
[picture p55: CAD file, 2026-07-15]
cad/improved_design/rr_dl_volume_improved_design/rr_dl_volume_improved_design.STEP
1.25 x 1.25 x 0.484 mm
