amsikking/idv-snouty_light-sheet_microscopy/cad/o1/lightsheet_green.STEP

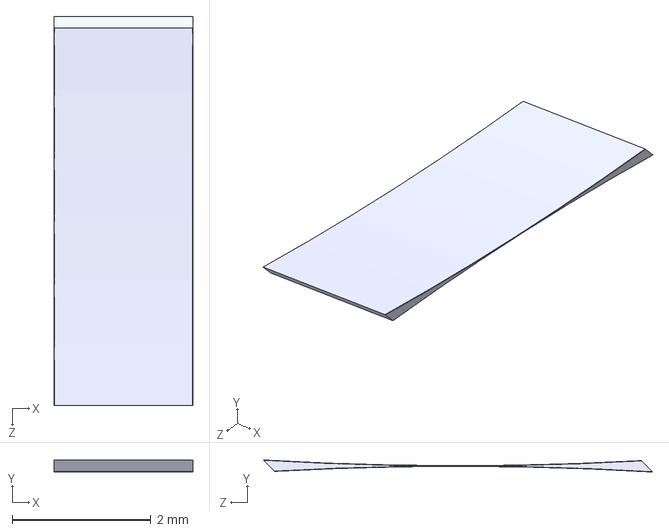
[picture p56: CAD file, 2026-07-18]
cad/o1/lightsheet_green.STEP
2.00 x 0.174 x 5.60 mm
