amsikking/idv-snouty_light-sheet_microscopy/cad/o2/nikon_mrd70270_20x0.8_air_objective.STEP

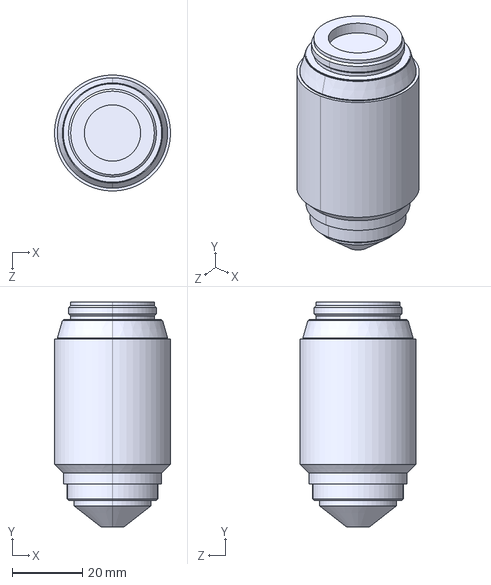
[picture p57: CAD file, 2026-07-15]
cad/o2/nikon_mrd70270_20x0.8_air_objective.STEP
33.0 x 64.0 x 33.0 mm
