amsikking/idv-snouty_light-sheet_microscopy/cad/o3/ams-agy_v3_57-14-7_revb_0.25mm_grind.SLDPRT

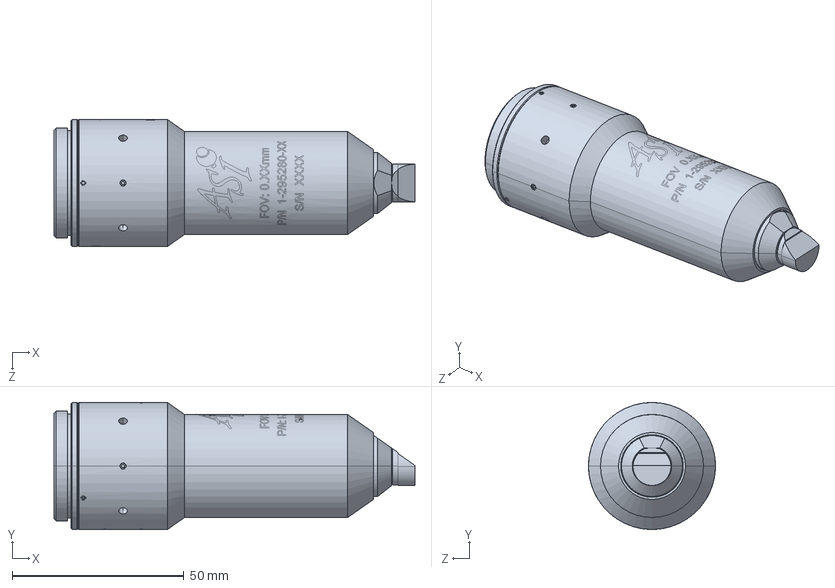
[picture p58: CAD file, 2026-07-15]
cad/o3/ams-agy_v3_57-14-7_revb_0.25mm_grind.SLDPRT
105.2 x 37.0 x 37.0 mm
