amsikking/idv-snouty_light-sheet_microscopy/cad/2d_fov/2d_fov_o2.SLDPRT

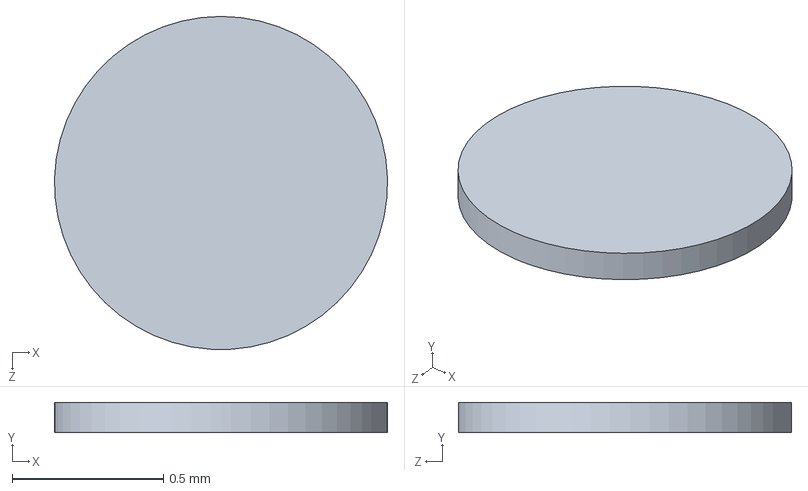
[picture p59: CAD file, 2026-07-15]
cad/2d_fov/2d_fov_o2.SLDPRT
1.10 x 0.1 x 1.10 mm
