amsikking/idv-snouty_light-sheet_microscopy/cad/o2/nikon_mrh08230_20x0.45_air_objective.STEP

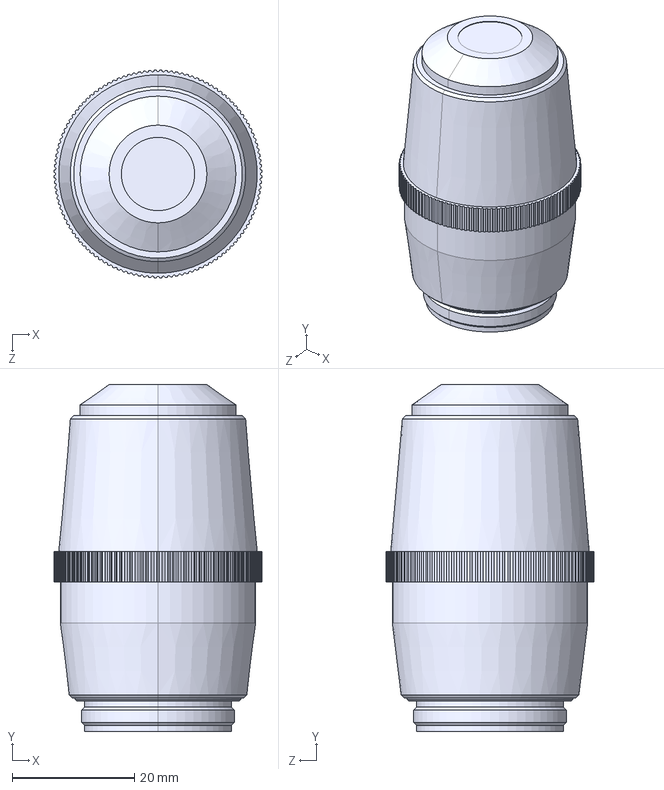
[picture p60: CAD file, 2026-07-15]
cad/o2/nikon_mrh08230_20x0.45_air_objective.STEP
34.0 x 56.8 x 34.0 mm
