amsikking/idv-snouty_light-sheet_microscopy/cad/tl2/efl150mm_tube_lens.STEP

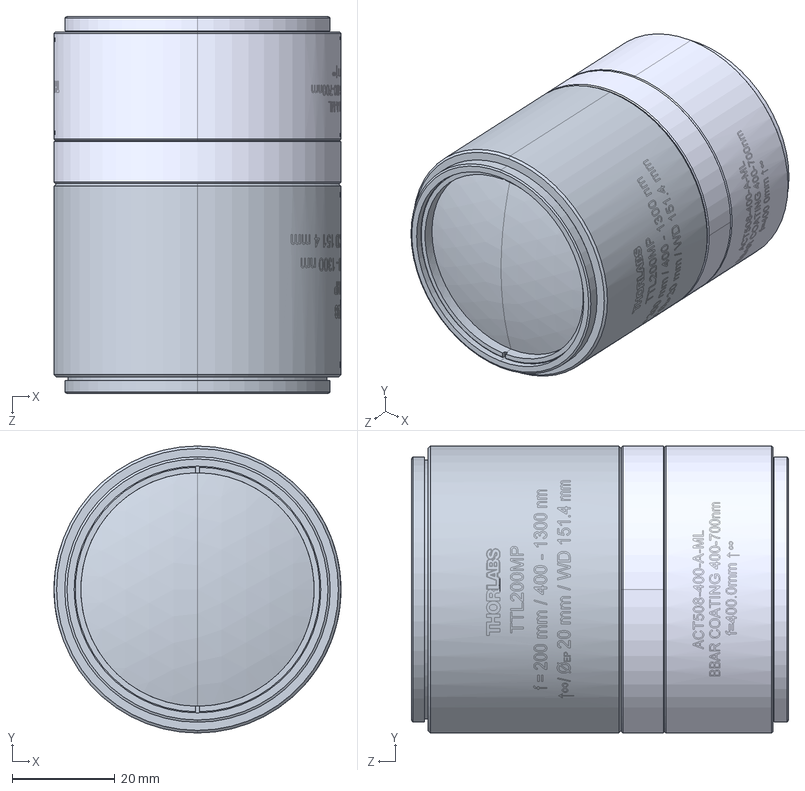
[picture p62: CAD file, 2026-07-15]
cad/tl2/efl150mm_tube_lens.STEP
55.9 x 55.9 x 73.4 mm
thorlabs_ttl200mp_200mm_tube_lens
thorlabs_act508-400-a-ml_400mm_achromat
thorlabs_sm2l03_0.3in_lens_tube
