amsikking/idv-snouty_light-sheet_microscopy/cad/o1/o1_lightsheets.STEP

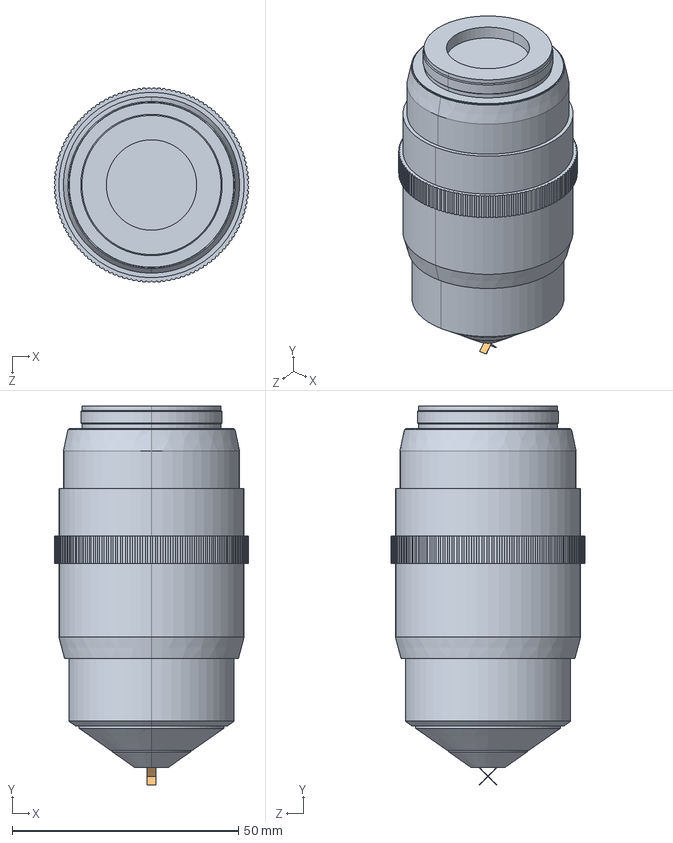
[picture p63: CAD file, 2026-07-18]
cad/o1/o1_lightsheets.STEP
43.0 x 83.8 x 43.0 mm
nikon_mrd77226_20x1.0_water_objective
lightsheet_green
lightsheet_red
