amsikking/idv-snouty_light-sheet_microscopy/cad/o1/nikon_mrd77226_20x1.0_water_objective.STEP

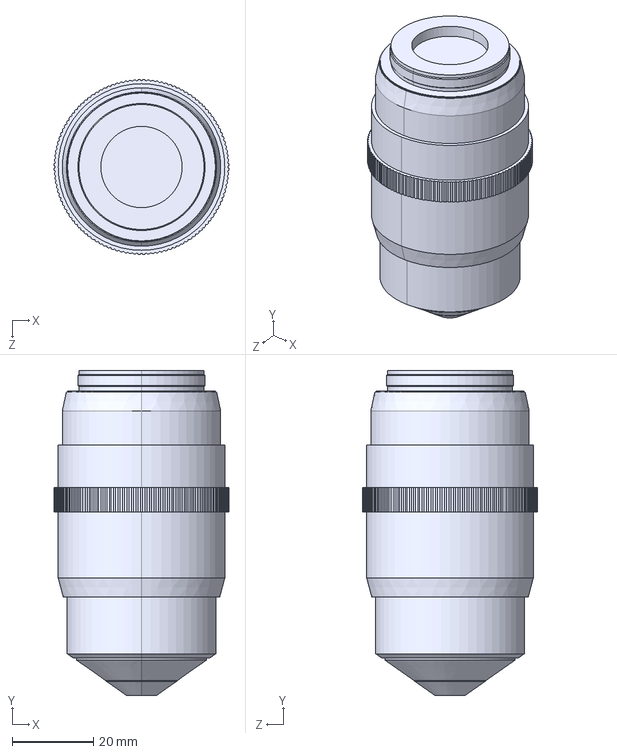
[picture p64: CAD file, 2026-07-15]
cad/o1/nikon_mrd77226_20x1.0_water_objective.STEP
43.0 x 80.0 x 43.0 mm
