amsikking/idv-snouty_light-sheet_microscopy/(list of files, cad)

Other CAD files:
cad/improved_design/idv_snouty_improved_design.STEP
cad/o1/lightsheet_red.STEP
cad/2d_fov/2d_fov.SLDDRW
cad/c/pco_edge10_bi_clhs.SLDPRT
cad/cs/coverslip_0.17mm_thick.SLDDRW
cad/cs/coverslip_0.17mm_thick.SLDPRT
cad/current_design/idv_snouty_current_design.SLDASM
cad/current_design/idv_snouty_current_design.SLDDRW
cad/current_design/m3_current_design/m3_current_design.SLDASM
cad/current_design/rr_dl_volume_current_design/rr_dl_volume_current_design.SLDDRW
cad/current_design/rr_dl_volume_current_design/rr_dl_volume_current_design.SLDPRT
cad/dm/chroma_zt405488561640rpcv2_rectangular_dichroic_1mm_thick.SLDDRW
cad/dm/chroma_zt405488561640rpcv2_rectangular_dichroic_1mm_thick.SLDPRT
cad/em/chroma_zet405488561640mv2_emission_filter_1mm_thick.SLDDRW
cad/em/chroma_zet405488561640mv2_emission_filter_1mm_thick.SLDPRT
cad/fm/thorlabs_bbe2-e02_2in_elliptical_mirror.sldprt
cad/improved_design/idv_snouty_improved_design.SLDASM
cad/improved_design/idv_snouty_improved_design.SLDDRW
cad/improved_design/m3_improved_design/m3_improved_design.SLDASM
cad/improved_design/rr_dl_volume_improved_design/rr_dl_volume_improved_design.SLDDRW
cad/improved_design/rr_dl_volume_improved_design/rr_dl_volume_improved_design.SLDPRT
cad/o1/lightsheet_green.SLDPRT
cad/o1/lightsheet_red.SLDPRT
cad/o1/nikon_mrd77226_20x1.0_water_objective.SLDPRT
cad/o1/o1_lightsheets.SLDASM
cad/o2/nikon_mrd70270_20x0.8_air_objective.SLDPRT
cad/o2/nikon_mrh08230_20x0.45_air_objective.SLDPRT
cad/o3/ams-agy_v3_57-14-7_revb_dual_grind.SLDDRW
cad/o3/ams-agy_v3_57-14-7_revb_dual_grind.SLDPRT
cad/os/thorlabs_qs20x-ag_20mm_galvo.sldprt
cad/tl1/thorlabs_ttl200mp_200mm_tube_lens.sldprt
cad/tl2/efl150mm_tube_lens.SLDASM
cad/tl2/efl150mm_tube_lens.SLDDRW
cad/tl2/thorlabs_act508-400-a-ml_400mm_achromat.sldprt
cad/tl2/thorlabs_sm2l03_0.3in_lens_tube.sldprt
cad/tl3/thorlabs_ttl180-a_180mm_tube_lens.sldprt
