amsikking/idv-snouty_light-sheet_microscopy/parts/efl150mm.pdf

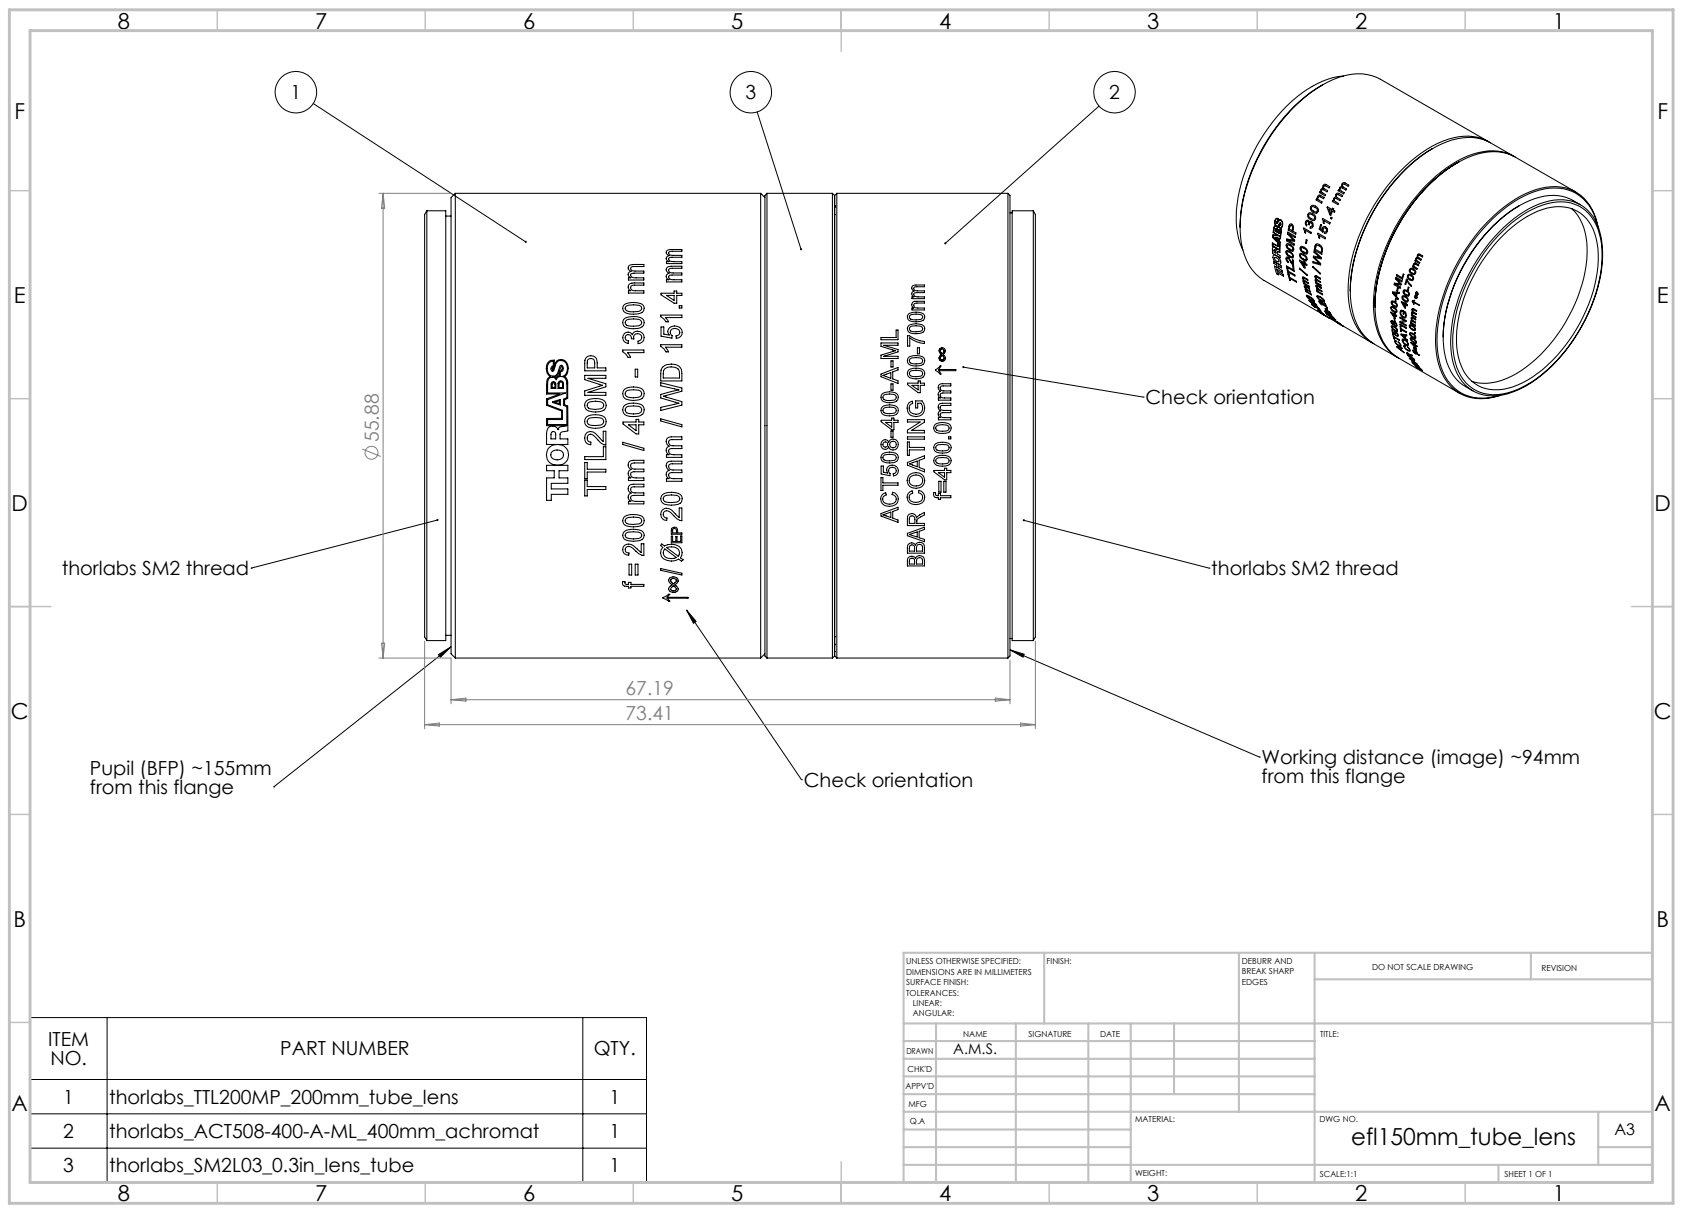
[picture p65: page 1]
Check orientation; thorlabs SM2 thread; FINISH:; DEBURR AND; BREAK SHARP; DO NOT SCALE DRAWING; REVISION; DWG NO.

Working distance (image) ~94mm

from this flange Pupil (BFP) ~155mm
from this flange

UNLESS OTHERWISE SPECIFIED:
DIMENSIONS ARE IN MILLIMETERS
SURFACE FINISH:
TOLERANCES:
LINEAR:
ANGULAR:

ITEM NO. | PART NUMBER | QTY.

DRAWN | A.M.S.

NAME | SIGNATURE | DATE | TITLE:

CHK'D

3 | thorlabs_SM2L03_0.3in_lens_tube | 1

WEIGHT: | SCALE:1:1 | SHEET 1 OF 1
