amsikking/idv-snouty_light-sheet_microscopy/cad/current_design/idv_snouty_current_design.pdf

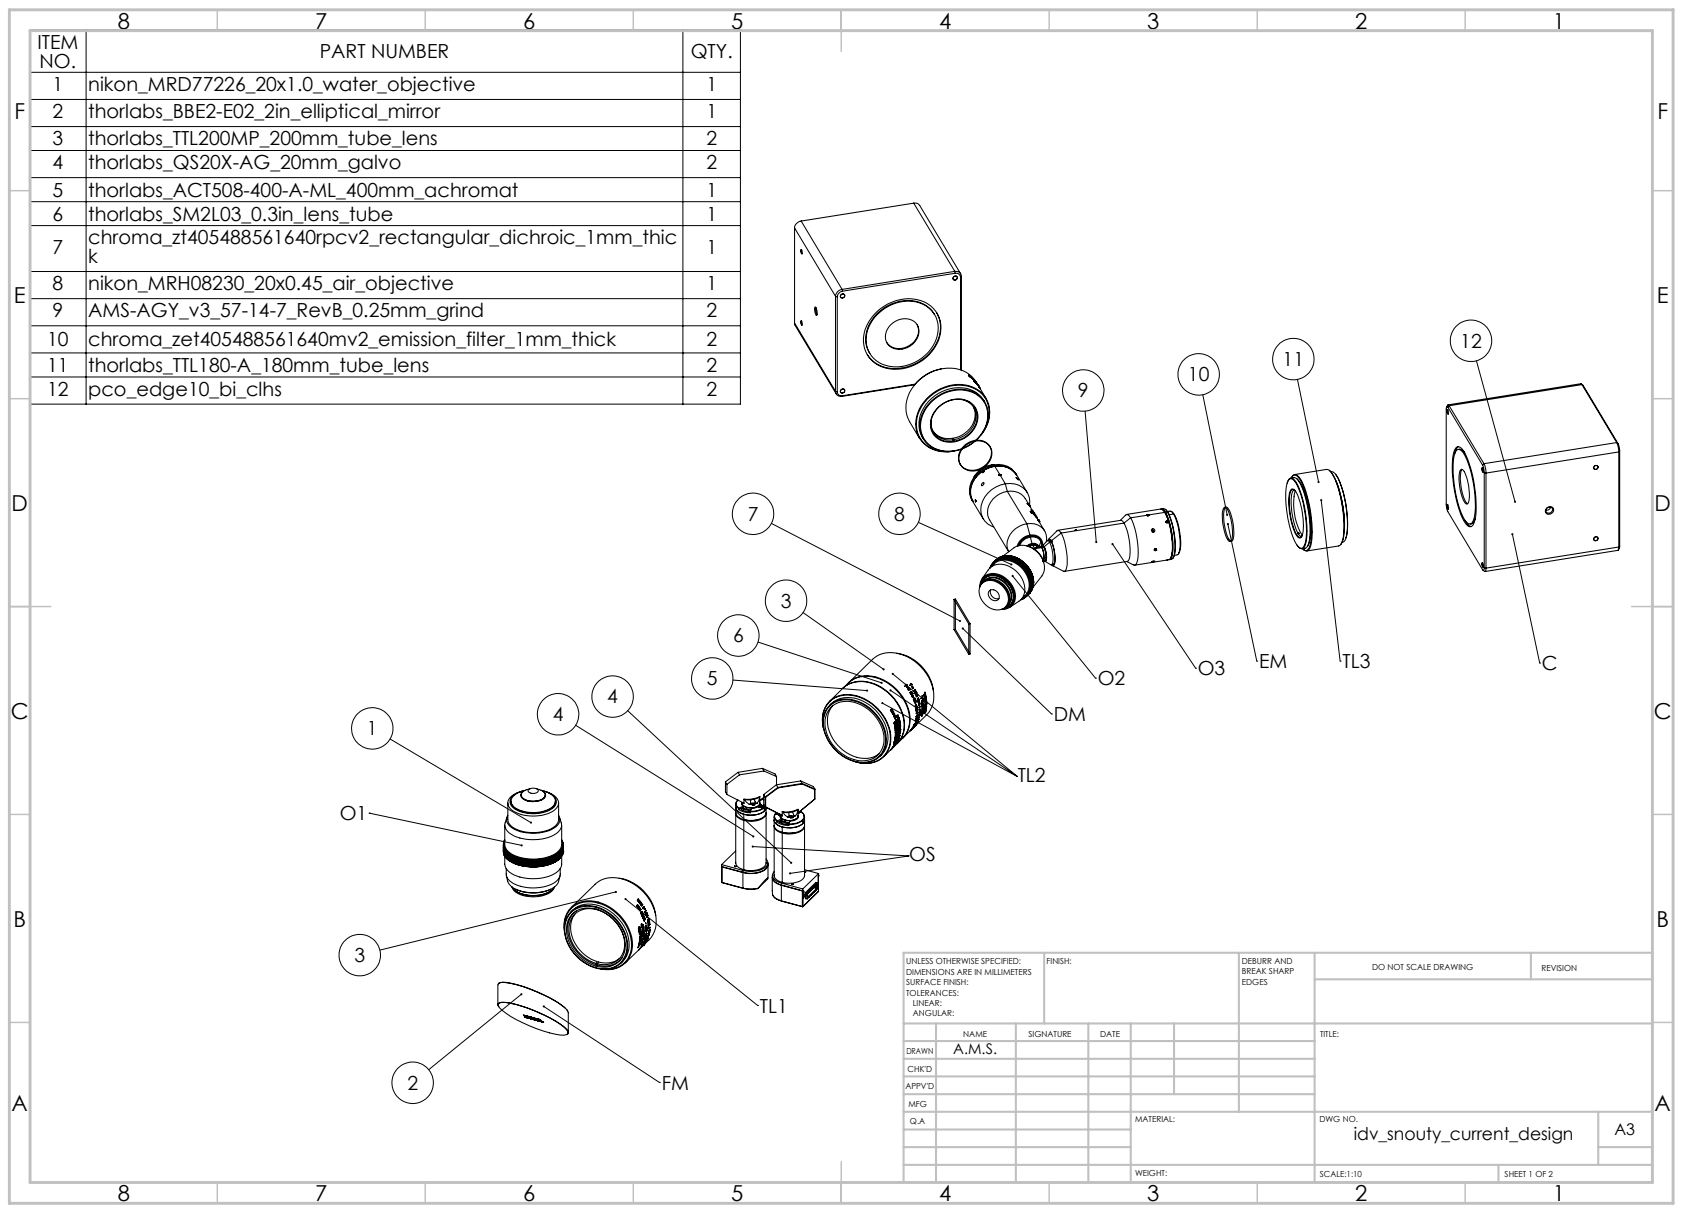
[picture p68: page 1]
FINISH:; DEBURR AND; BREAK SHARP; DO NOT SCALE DRAWING; REVISION; SCALE:1:10; SHEET 1 OF 2

ITEM NO. | PART NUMBER | QTY.
1 | nikon_MRD77226_20x1.0_water_objective | 1
2 | thorlabs_BBE2-E02_2in_elliptical_mirror | 1
3 | thorlabs_TTL200MP_200mm_tube_lens | 2
4 | thorlabs_QS20X-AG_20mm_galvo | 2
5 | thorlabs_ACT508-400-A-ML_400mm_achromat | 1
6 | thorlabs_SM2L03_0.3in_lens_tube | 1
7 | chroma_zt405488561640rpcv2_rectangular_dichroic_1mm_thic k | 1
8 | nikon_MRH08230_20x0.45_air_objective | 1
9 | AMS-AGY_v3_57-14-7_RevB_0.25mm_grind | 2
10 | chroma_zet405488561640mv2_emission_filter_1mm_thick | 2
11 | thorlabs_TTL180-A_180mm_tube_lens | 2
12 | pco_edge10_bi_clhs | 2

UNLESS OTHERWISE SPECIFIED:
DIMENSIONS ARE IN MILLIMETERS
SURFACE FINISH:
TOLERANCES:
LINEAR:
ANGULAR:

DRAWN | A.M.S.

NAME | SIGNATURE | DATE | | | | TITLE:

CHK'D
APPV'D
MFG
Q.A | | | | MATERIAL: | DWG NO. idv_snouty_current_design | A3

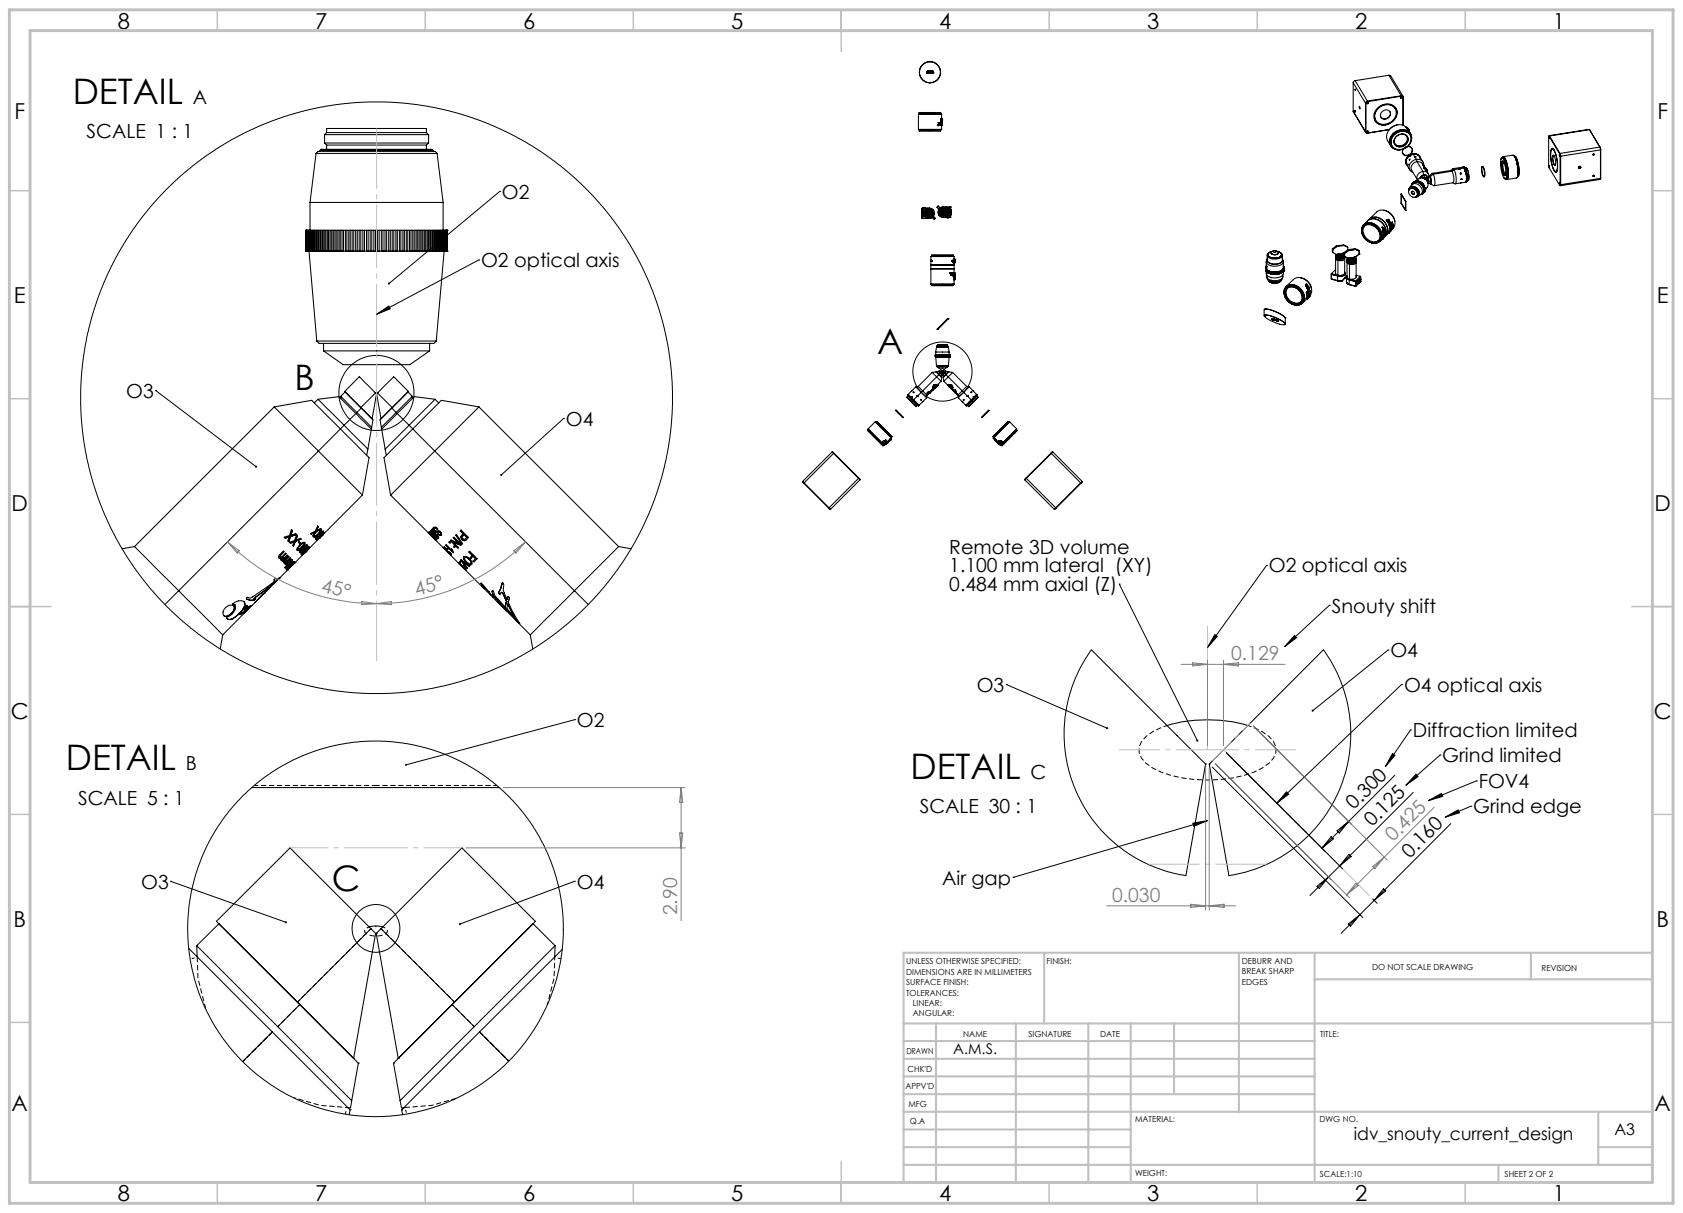
[picture p69: page 2]
DETAIL A; SCALE 1 : 1; O2 optical axis; DETAIL B; SCALE 5 : 1; DETAIL C; SCALE 30 : 1; O4 optical axis; Air gap; Snouty shift; Diffraction limited; Grind edge; Grind limited; FINISH:; DEBURR AND; BREAK SHARP; DO NOT SCALE DRAWING; REVISION; SCALE:1:10; SHEET 2 OF 2

Remote 3D volume
1.100 mm lateral (XY)
0.484 mm axial (Z)

UNLESS OTHERWISE SPECIFIED:
DIMENSIONS ARE IN MILLIMETERS
SURFACE FINISH:
TOLERANCES:
LINEAR:
ANGULAR:

DRAWN | A.M.S.

NAME | SIGNATURE | DATE | | | | TITLE:

CHK'D
APPV'D
MFG
Q.A | | | | MATERIAL: | DWG NO. idv_snouty_current_design | A3
