amsikking/idv-snouty_light-sheet_microscopy/cad/improved_design/rr_dl_volume_improved_design/rr_dl_volume_improved_design.pdf

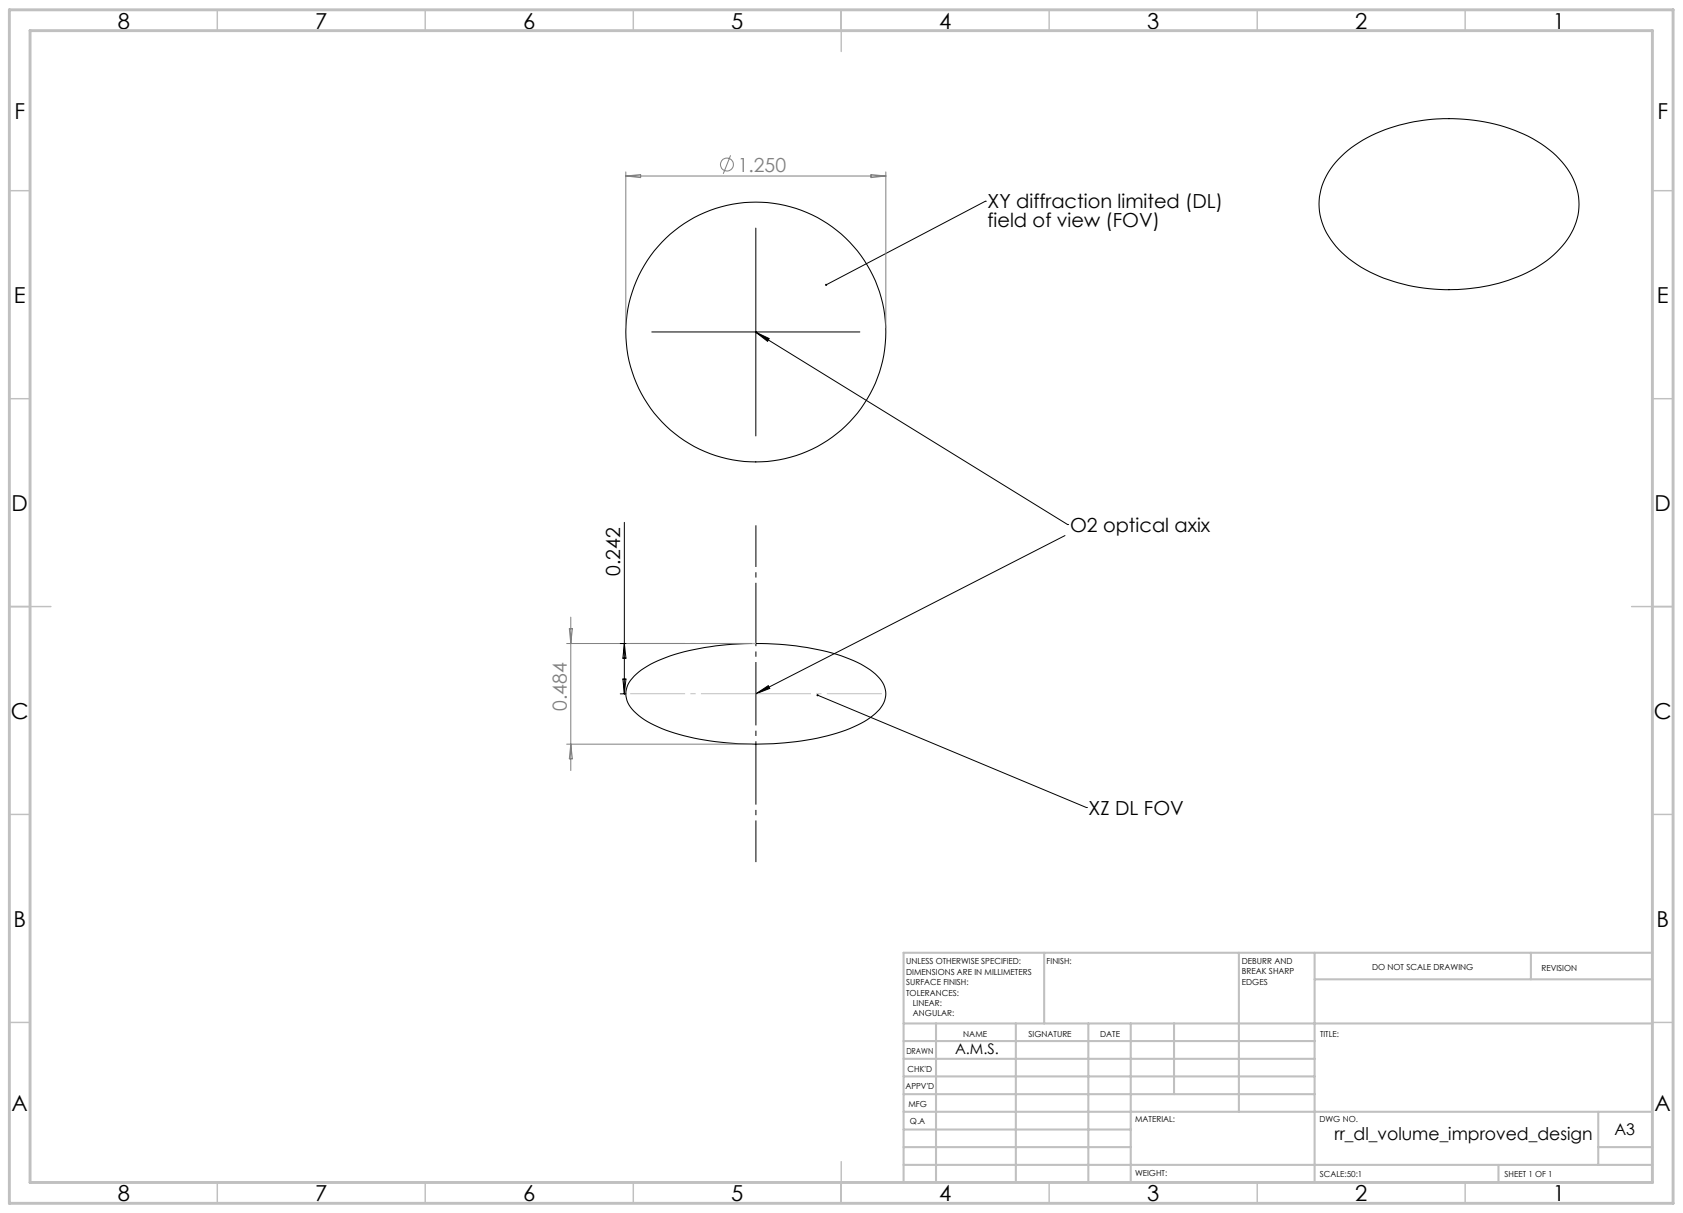
[picture p70: page 1]
O2 optical axix; FINISH:; DEBURR AND; BREAK SHARP; DO NOT SCALE DRAWING; REVISION; SCALE:50:1; SHEET 1 OF 1

XY diffraction limited (DL)
field of view (FOV)

XZ DL FOV

UNLESS OTHERWISE SPECIFIED:
DIMENSIONS ARE IN MILLIMETERS
SURFACE FINISH:
TOLERANCES:
LINEAR:
ANGULAR:

DRAWN | A.M.S.

NAME | SIGNATURE | DATE | | | | TITLE:

CHK'D
APPV'D
MFG
Q.A | | | | MATERIAL: | DWG NO. rr_dl_volume_improved_design | A3
