amsikking/idv-snouty_light-sheet_microscopy/cad/o3/ams-agy_v3_57-14-7_revb_dual_grind.pdf

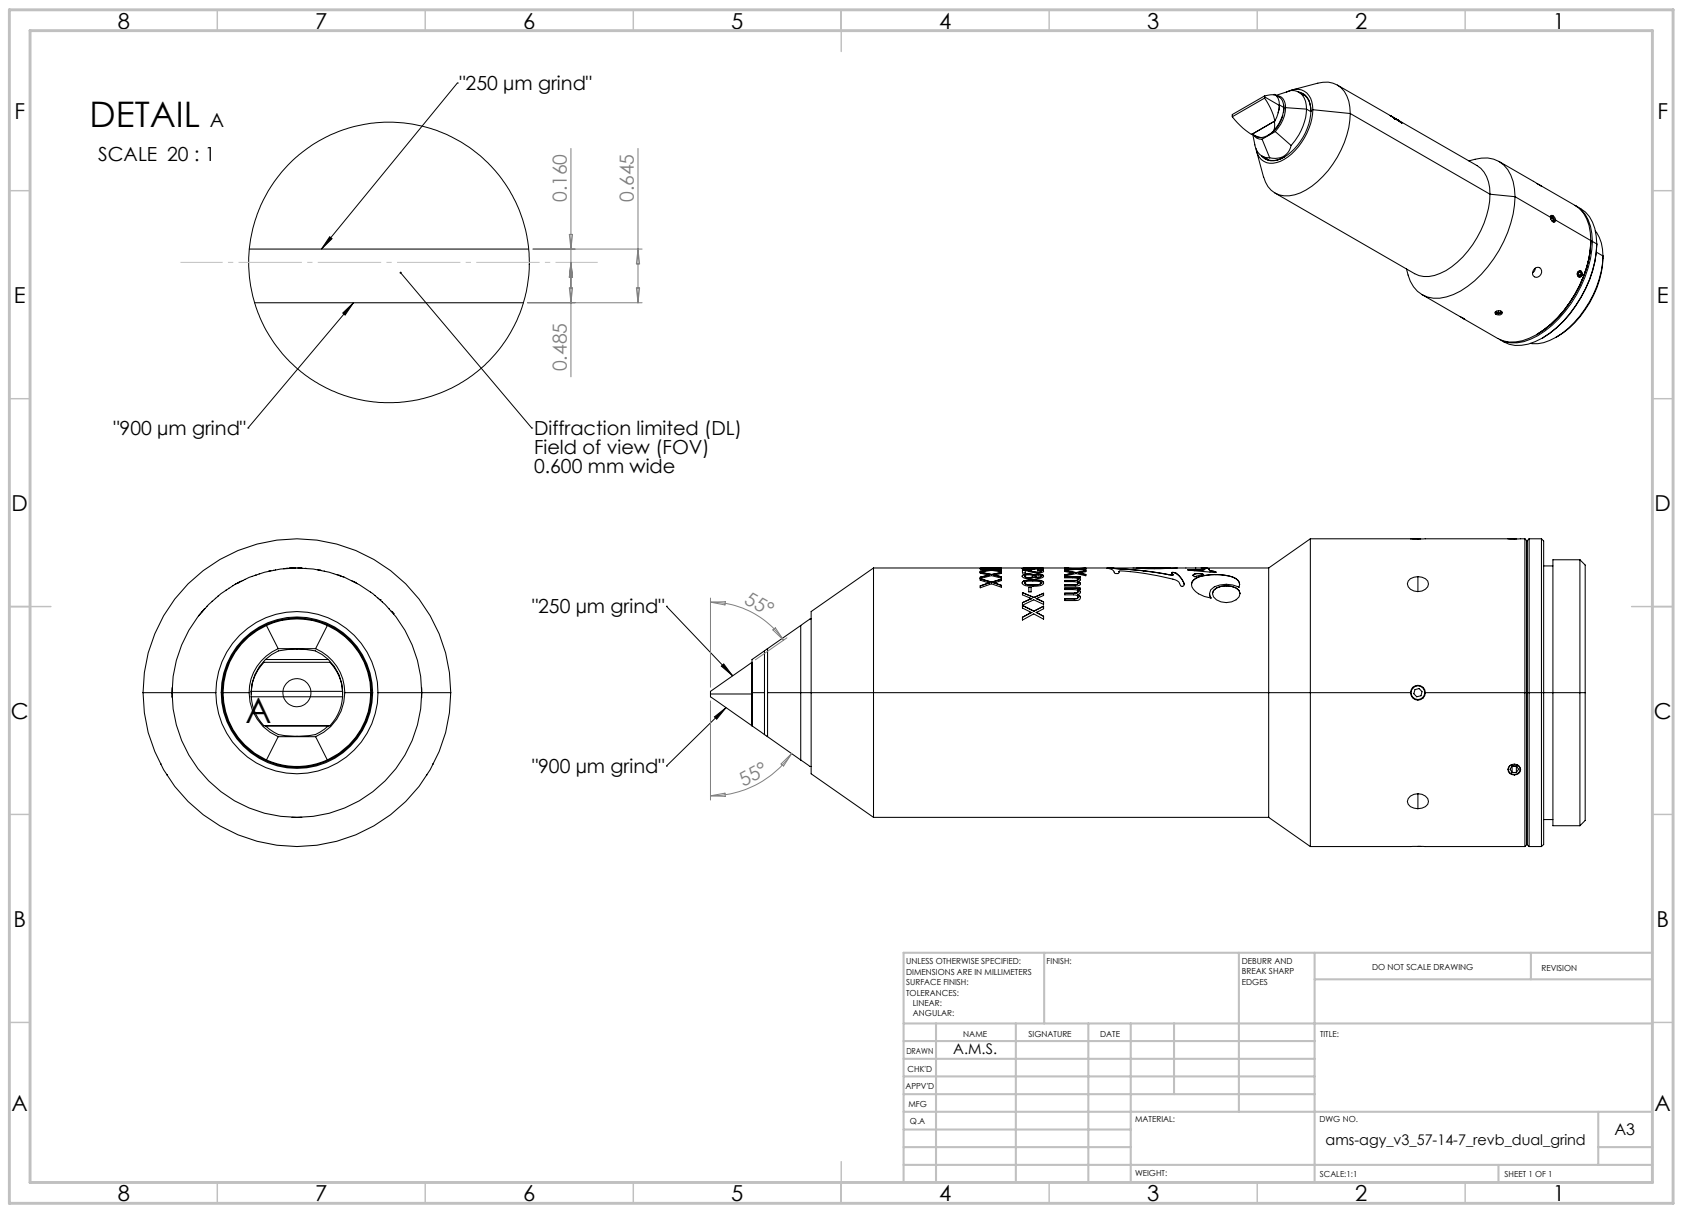
[picture p71: page 1]
"900 µm grind"; "250 µm grind"; DETAIL A; SCALE 20 : 1; FINISH:; DEBURR AND; BREAK SHARP; DO NOT SCALE DRAWING; REVISION; SCALE:1:1; SHEET 1 OF 1

Diffraction limited (DL)
Field of view (FOV)
0.600 mm wide

UNLESS OTHERWISE SPECIFIED:
DIMENSIONS ARE IN MILLIMETERS
SURFACE FINISH:
TOLERANCES:
LINEAR:
ANGULAR:

DRAWN | A.M.S.

NAME | SIGNATURE | DATE | | | | TITLE:

CHK'D
APPV'D
MFG
Q.A | | | | MATERIAL: | DWG NO. ams-agy_v3_57-14-7_revb_dual_grind | A3
