amsikking/idv-snouty_light-sheet_microscopy/cad/dm/chroma_zt405488561640rpcv2_rectangular_dichroic_1mm_thick.pdf

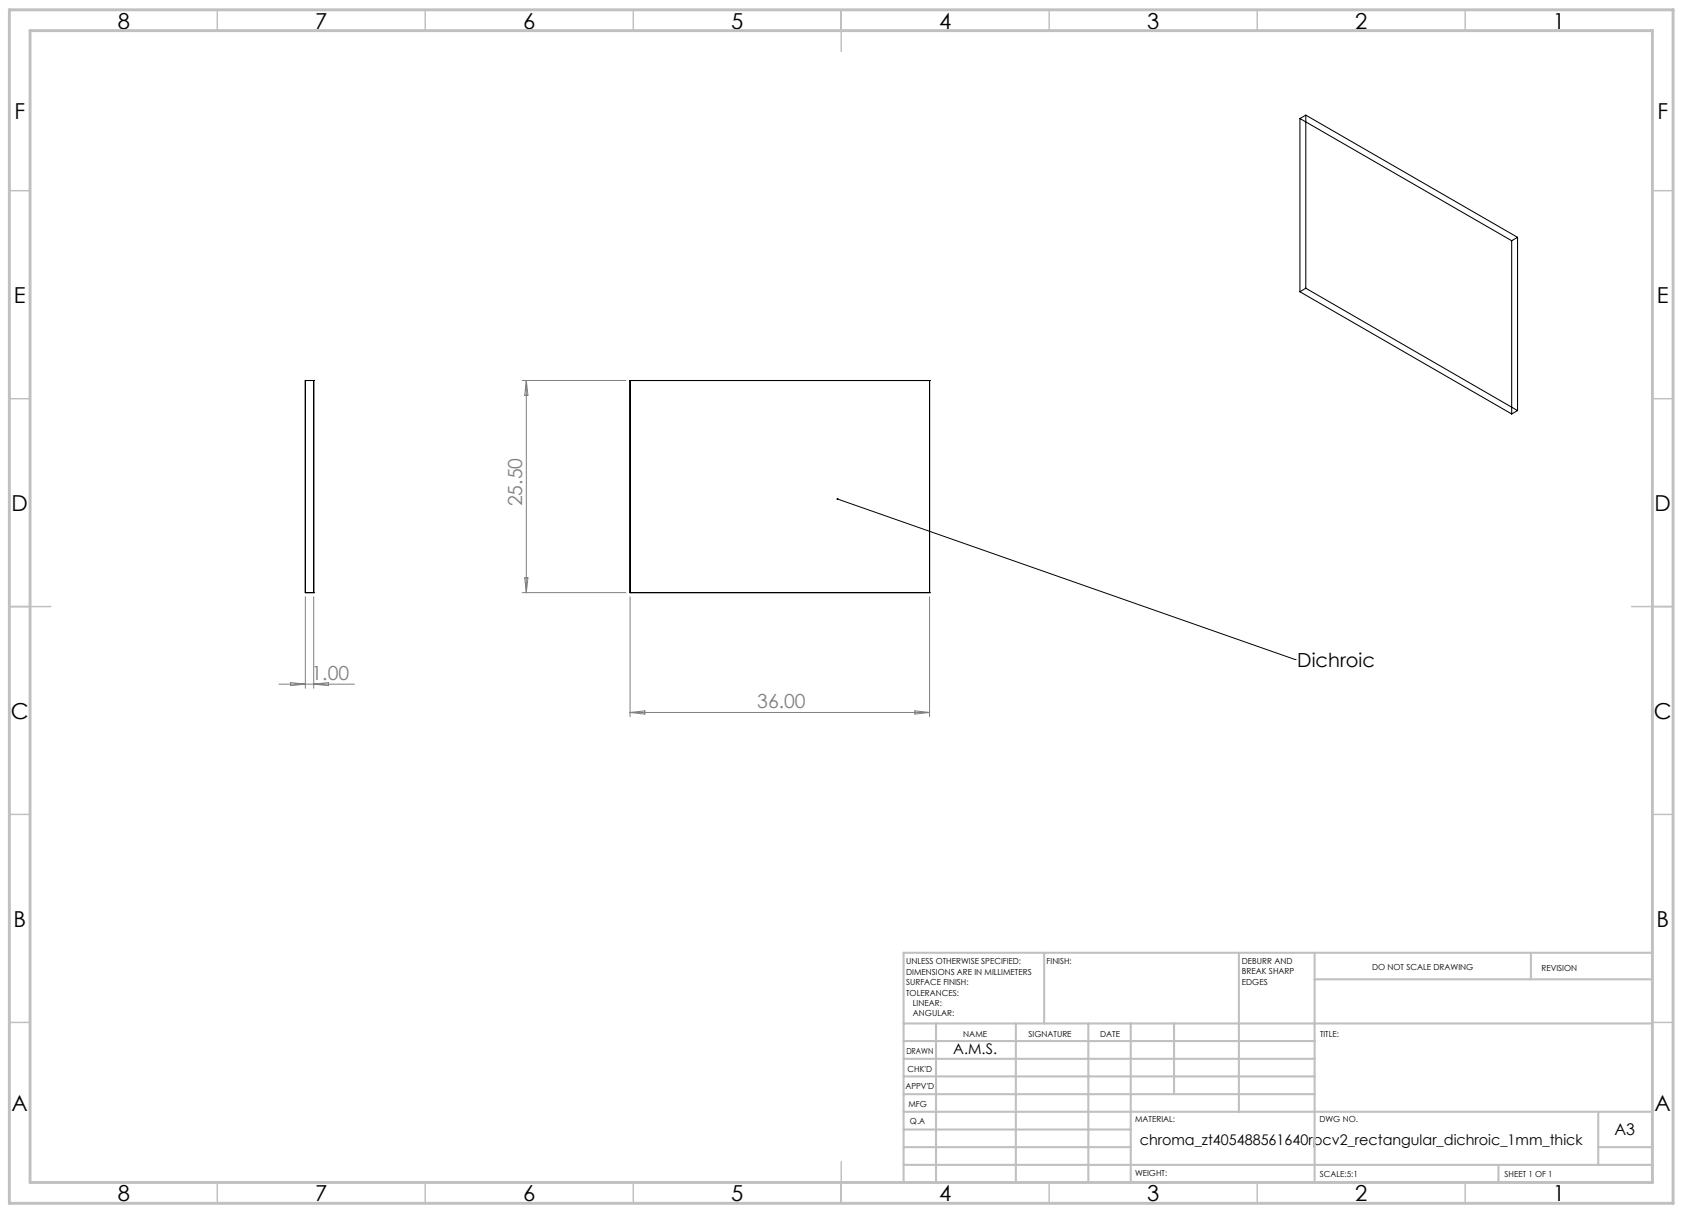
[picture p72: page 1]
Dichroic 1.00; FINISH:; DEBURR AND; BREAK SHARP; DO NOT SCALE DRAWING; REVISION; SCALE:5:1; SHEET 1 OF 1

UNLESS OTHERWISE SPECIFIED:
DIMENSIONS ARE IN MILLIMETERS
SURFACE FINISH:
TOLERANCES:
LINEAR:
ANGULAR:

DRAWN | A.M.S.

NAME | SIGNATURE | DATE | | | | TITLE:

CHK'D
APPV'D
MFG
Q.A | | | | MATERIAL: chroma_zt405488561640rpcv2_rectangular_dichroic_1mm_thick | DWG NO. | A3
