amsikking/idv-snouty_light-sheet_microscopy/cad/em/chroma_zet405488561640mv2_emission_filter_1mm_thick.pdf

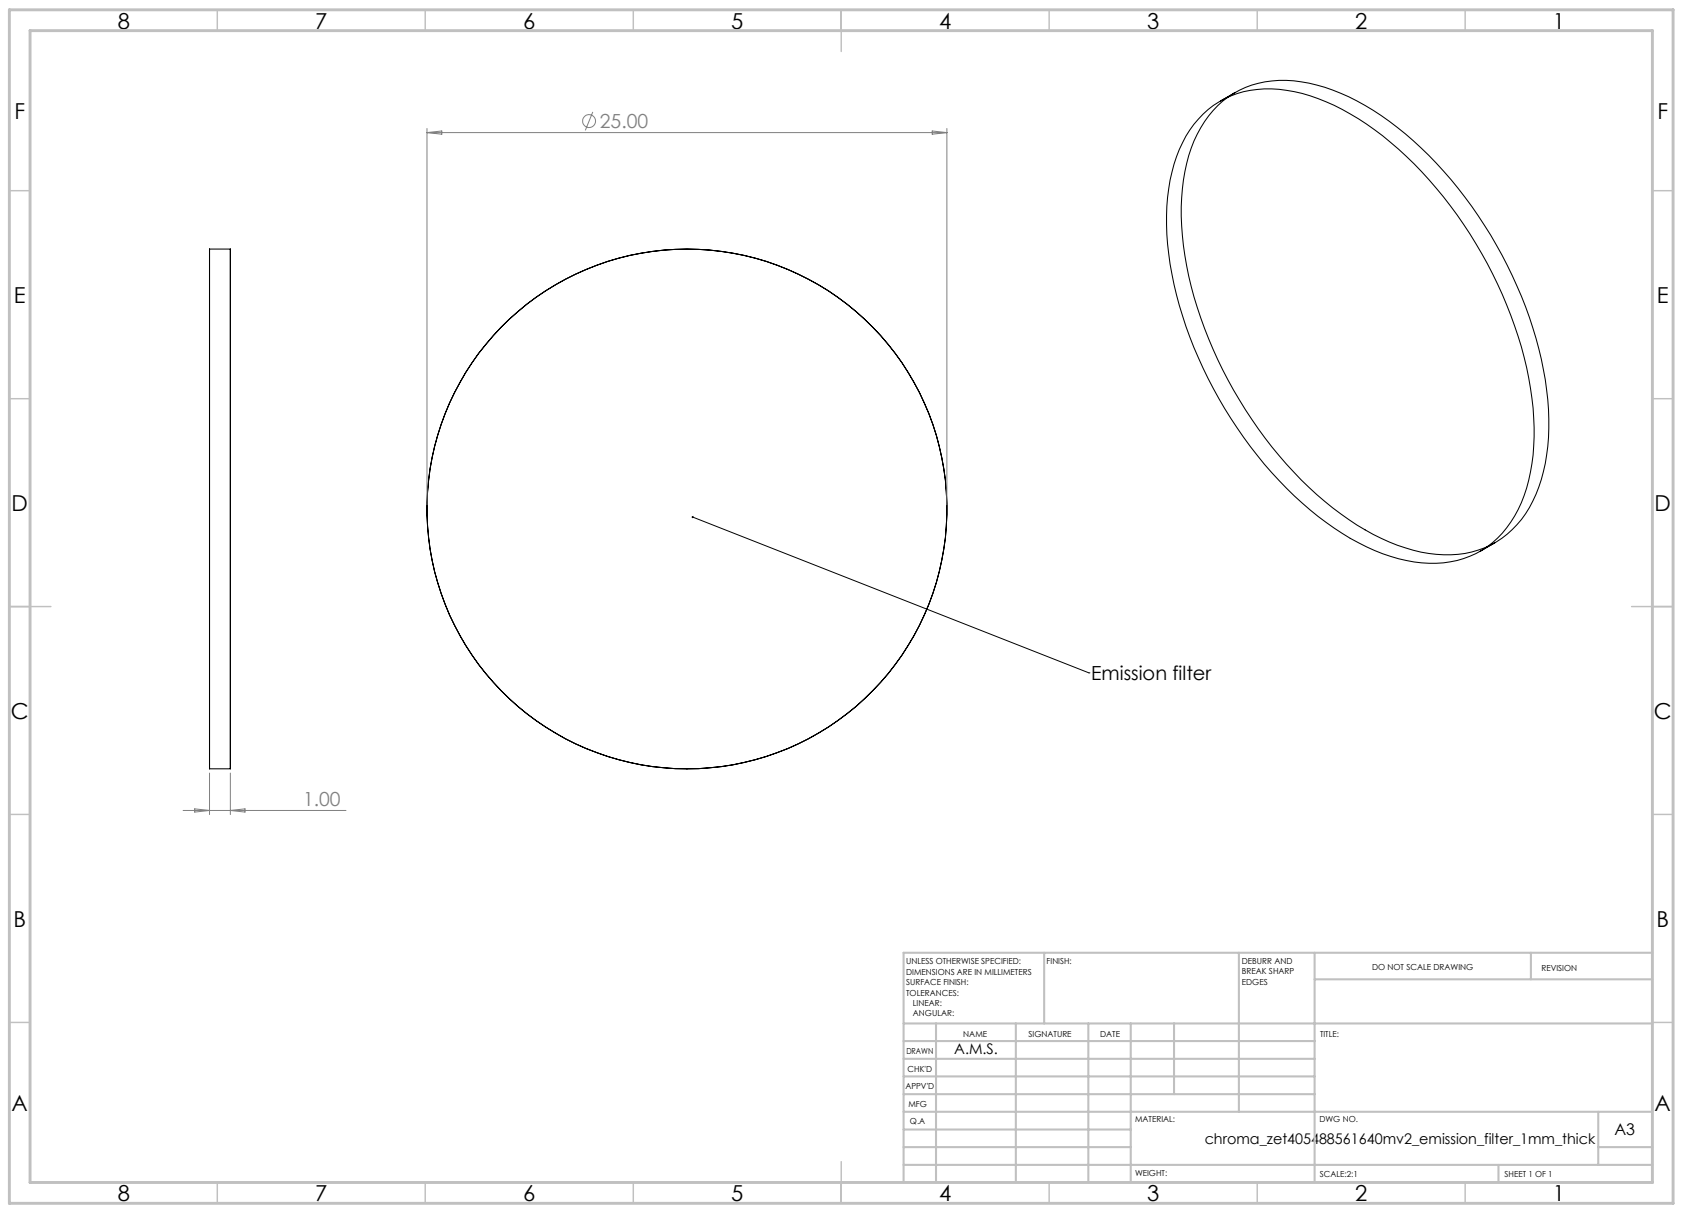
[picture p73: page 1]
Emission filter; FINISH:; DEBURR AND; BREAK SHARP; DO NOT SCALE DRAWING; REVISION; SCALE:2:1; SHEET 1 OF 1

UNLESS OTHERWISE SPECIFIED:
DIMENSIONS ARE IN MILLIMETERS
SURFACE FINISH:
TOLERANCES:
LINEAR:
ANGULAR:

DRAWN | A.M.S.

NAME | SIGNATURE | DATE | | | | TITLE:

CHK'D
APPV'D
MFG
Q.A | | | | MATERIAL: chroma_zet405488561640mv2_emission_filter_1mm_thick | DWG NO. | A3
