amsikking/idv-snouty_light-sheet_microscopy/cad/2d_fov/2d_fov.pdf

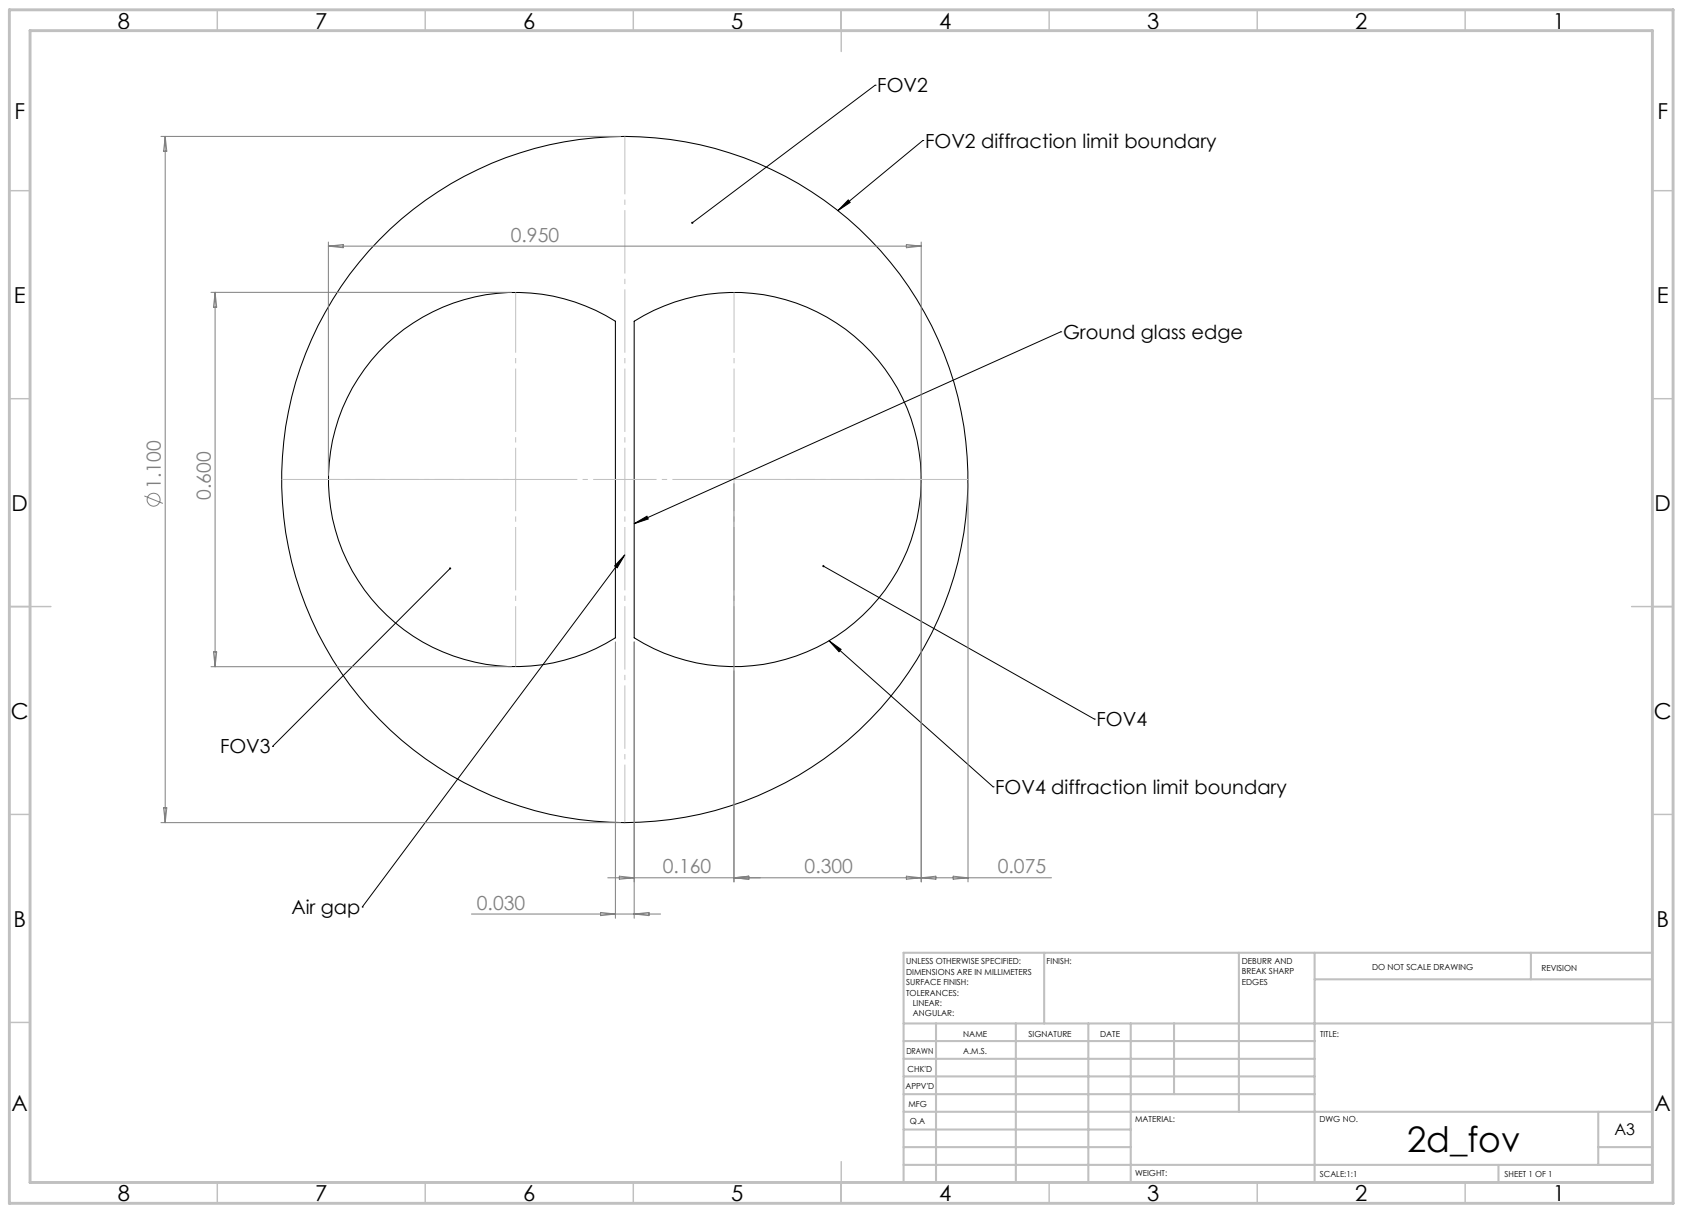
[picture p74: page 1]
Air gap; FINISH:; DEBURR AND; BREAK SHARP; DO NOT SCALE DRAWING; REVISION; SCALE:1:1; SHEET 1 OF 1

FOV2 diffraction limit boundary

Ground glass edge

FOV4 diffraction limit boundary

UNLESS OTHERWISE SPECIFIED:
DIMENSIONS ARE IN MILLIMETERS
SURFACE FINISH:
TOLERANCES:
LINEAR:
ANGULAR:

NAME | SIGNATURE | DATE | | | | TITLE:

DRAWN | A.M.S.
CHK'D
APPV'D
MFG
Q.A | | | | MATERIAL: | DWG NO. 2d_fov | A3
