amsikking/idv-snouty_light-sheet_microscopy/(notices)

Notices in the files:
README.md:
CC BY 4.0
